JohnFrei/Box-Joint-Jig/README.md

# Box-Joint-Jig
Plans for a Box Joint Jig
