JohnFrei/Box-Joint-Jig/templates/Scaling Readme.docx

The scaling for the gears should be 1.02 using PDF “all_sizes” document.
