JohnFrei/Box-Joint-Jig/plans.pdf

# How to view the screw advance box joint jig plans

To view the plans, you need to fully extract the entire zip file.

Extracting the zip file will create a folder with the plans in them.

Then navigate into the folder that the zip file was extracted into and double click on "index.html". If you click on the "index.html in the zip file directly, you will not be able to see the images or navigate between pages.

This file "plans.pdf" does not contain the plans (see below)

If you encounter any problems or have questions, please feel free to email me at: matthias@woodgears.ca

You may wonder, why does the file called "plans.pdf" not contain the actual plans? I have difficulty getting people to read the instructions about unpacking the
zip file, despite indicating how every step along the way. So the hope is that
if you don't read the instructions, you may open "plans.pdf" and then, finally,
read about unpacking the zip file. Enjoy the plans :)
