JohnFrei/Box-Joint-Jig/templates/1-1_small.pdf

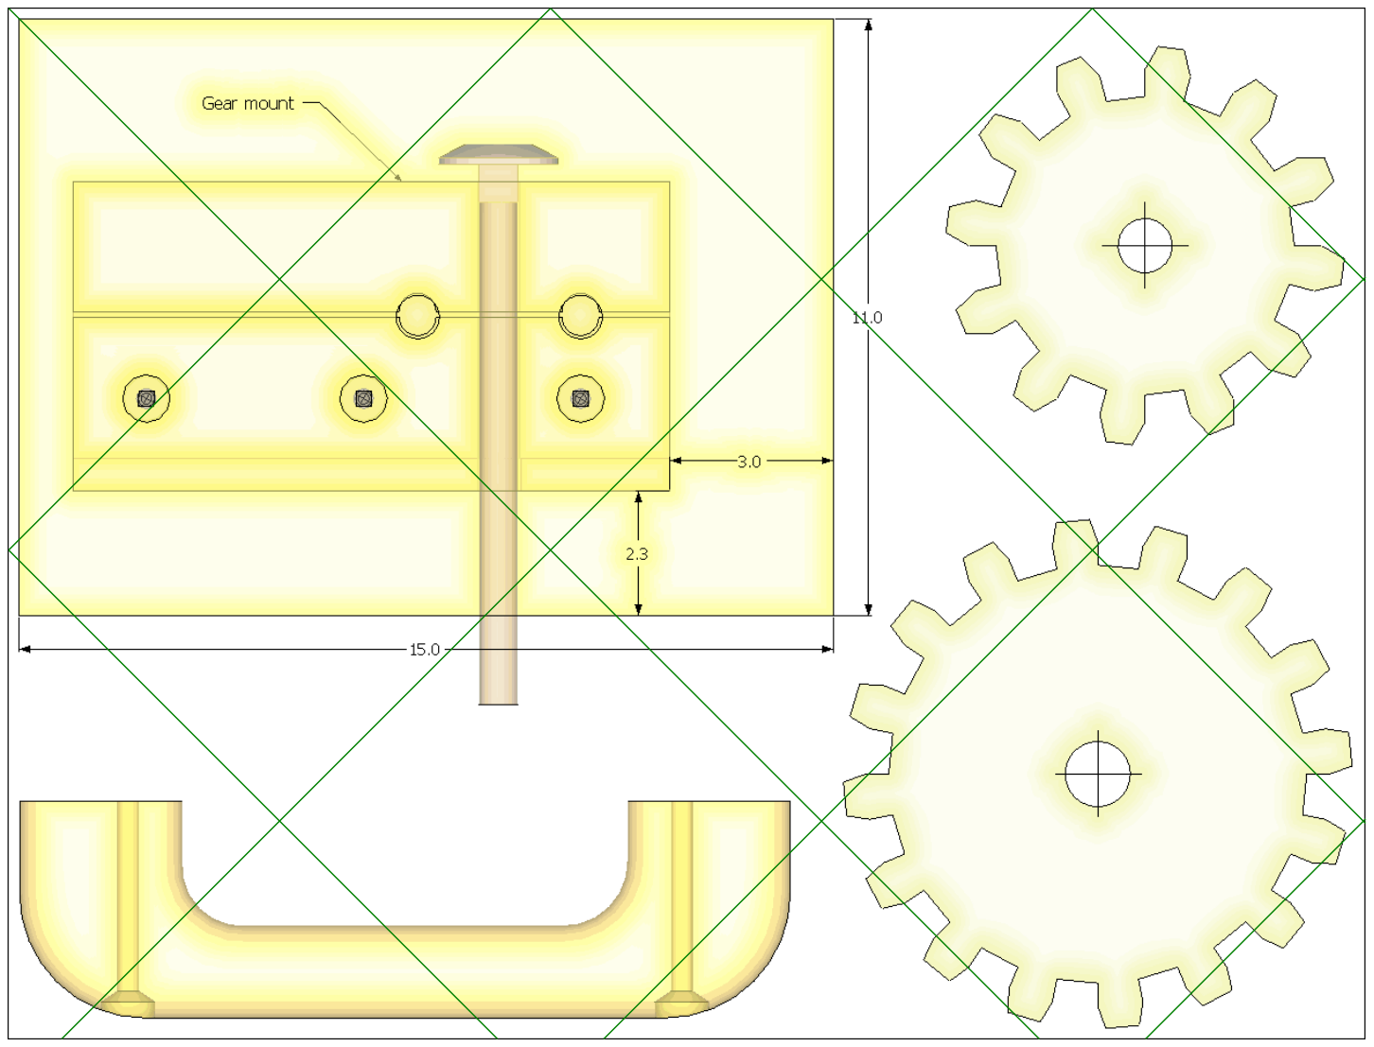
[picture p1: page 1]
