JohnFrei/Box-Joint-Jig/plans/base.png

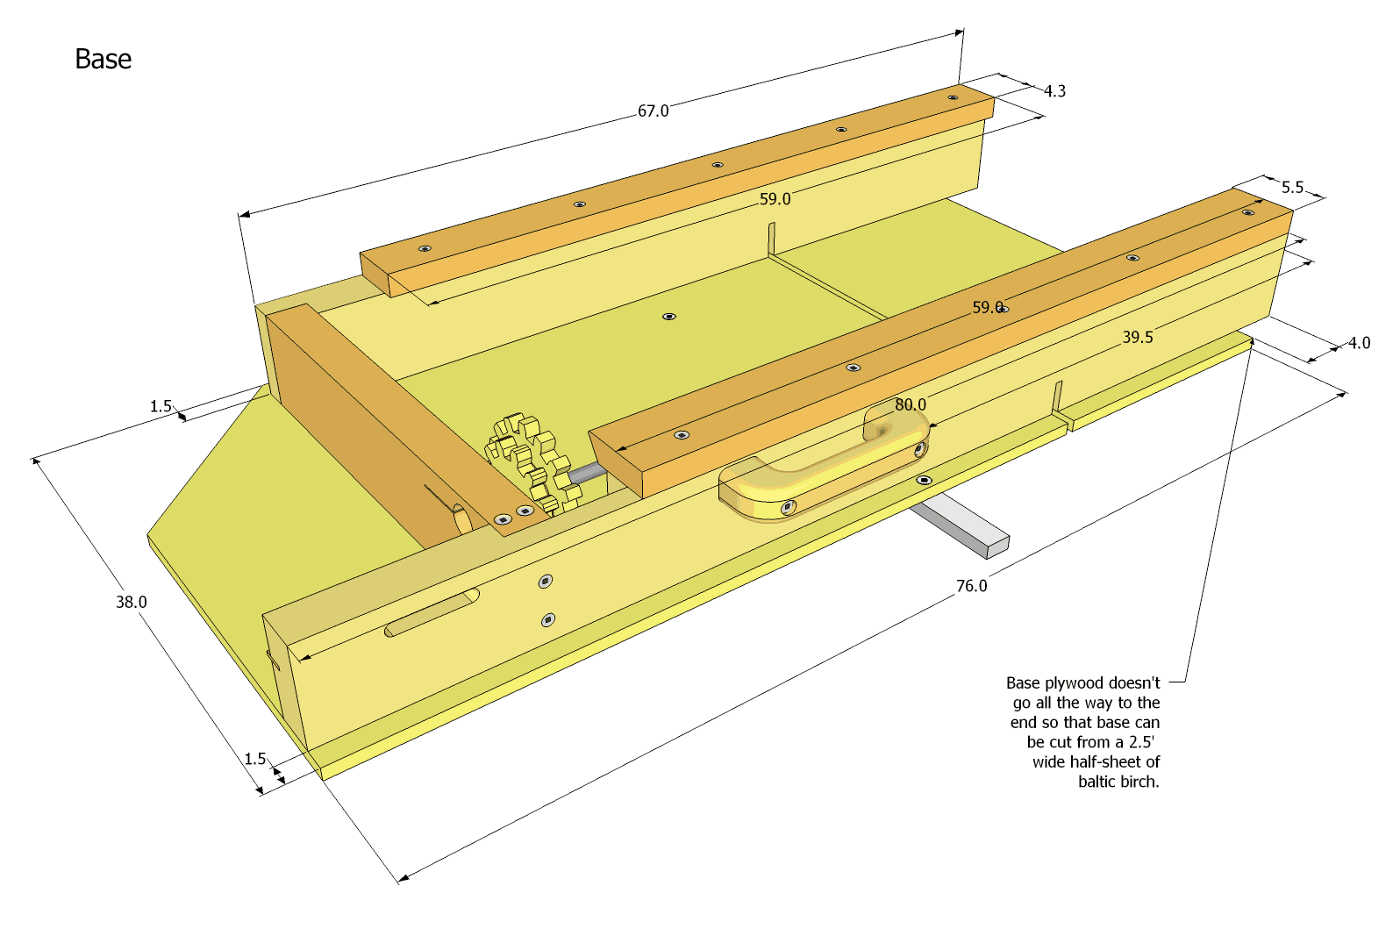
plans/base.png
