JohnFrei/Box-Joint-Jig/plans/base_plywood.png

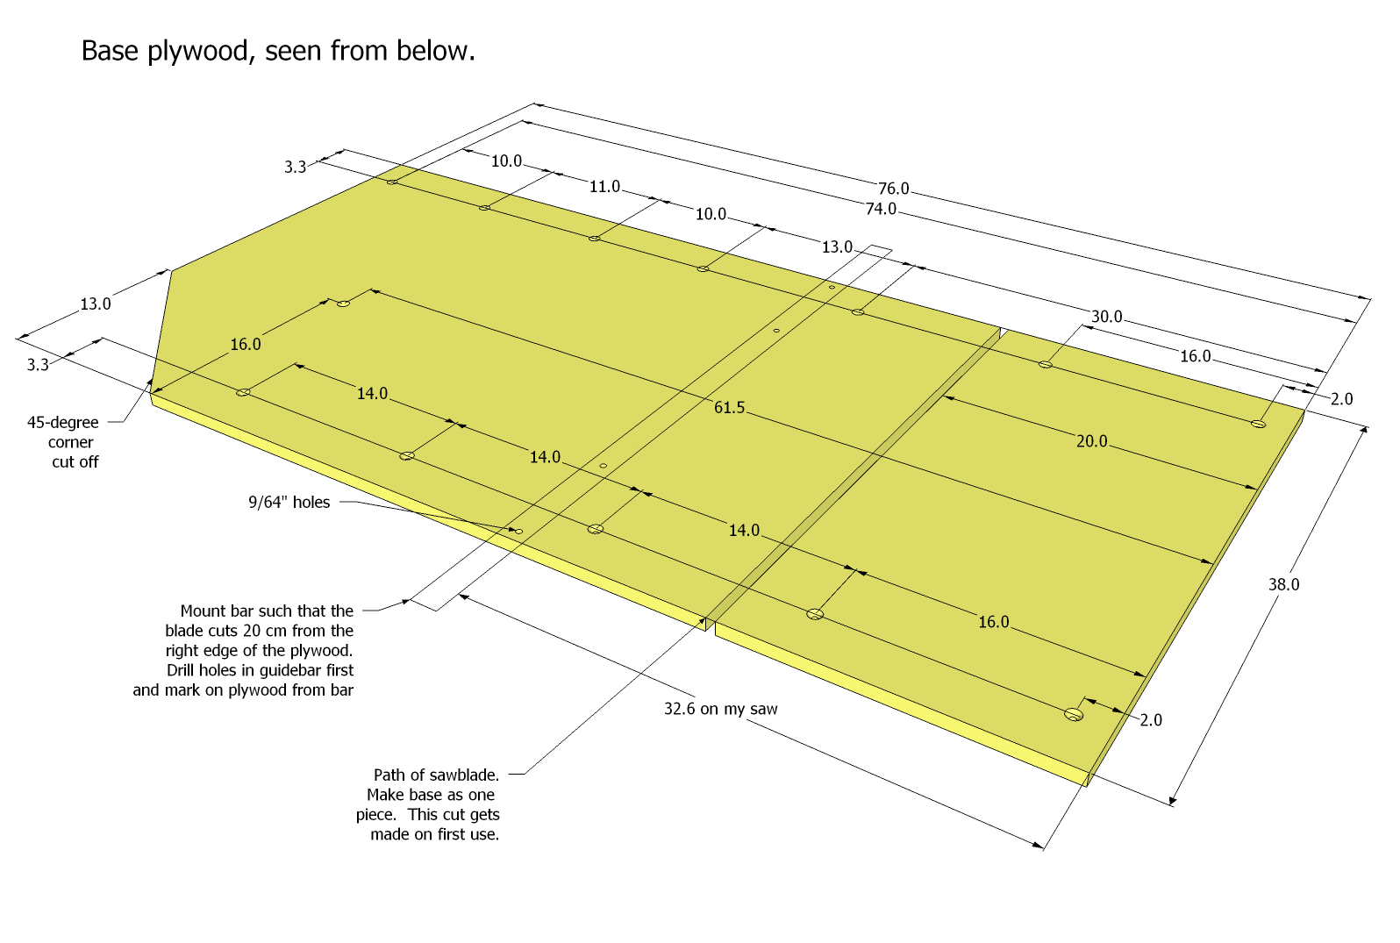
plans/base_plywood.png
