JohnFrei/Box-Joint-Jig/plans/box_basic.png

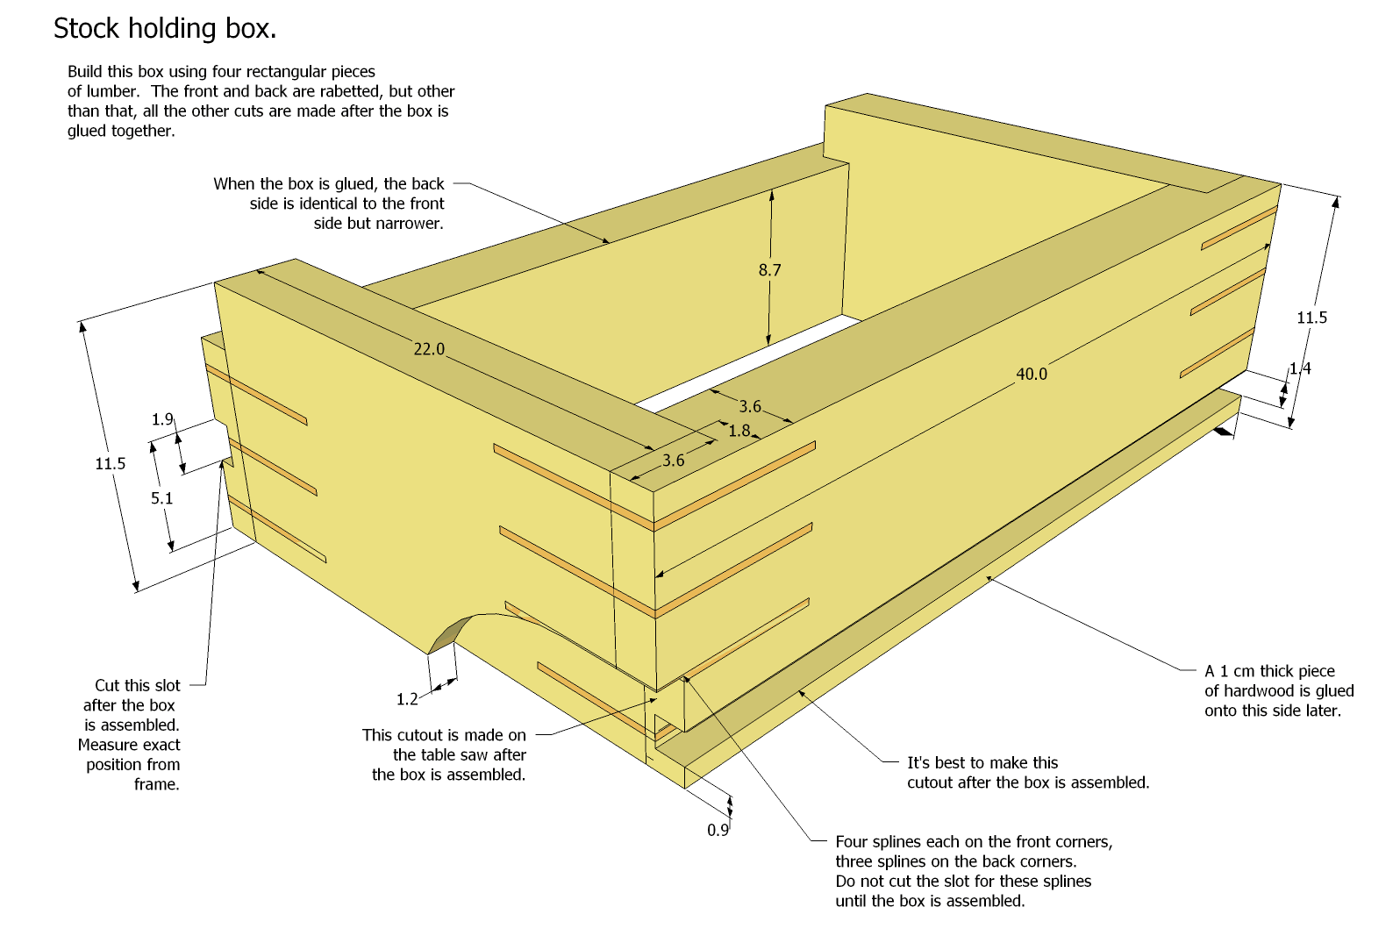
plans/box_basic.png
