JohnFrei/Box-Joint-Jig/plans/box_profile.png

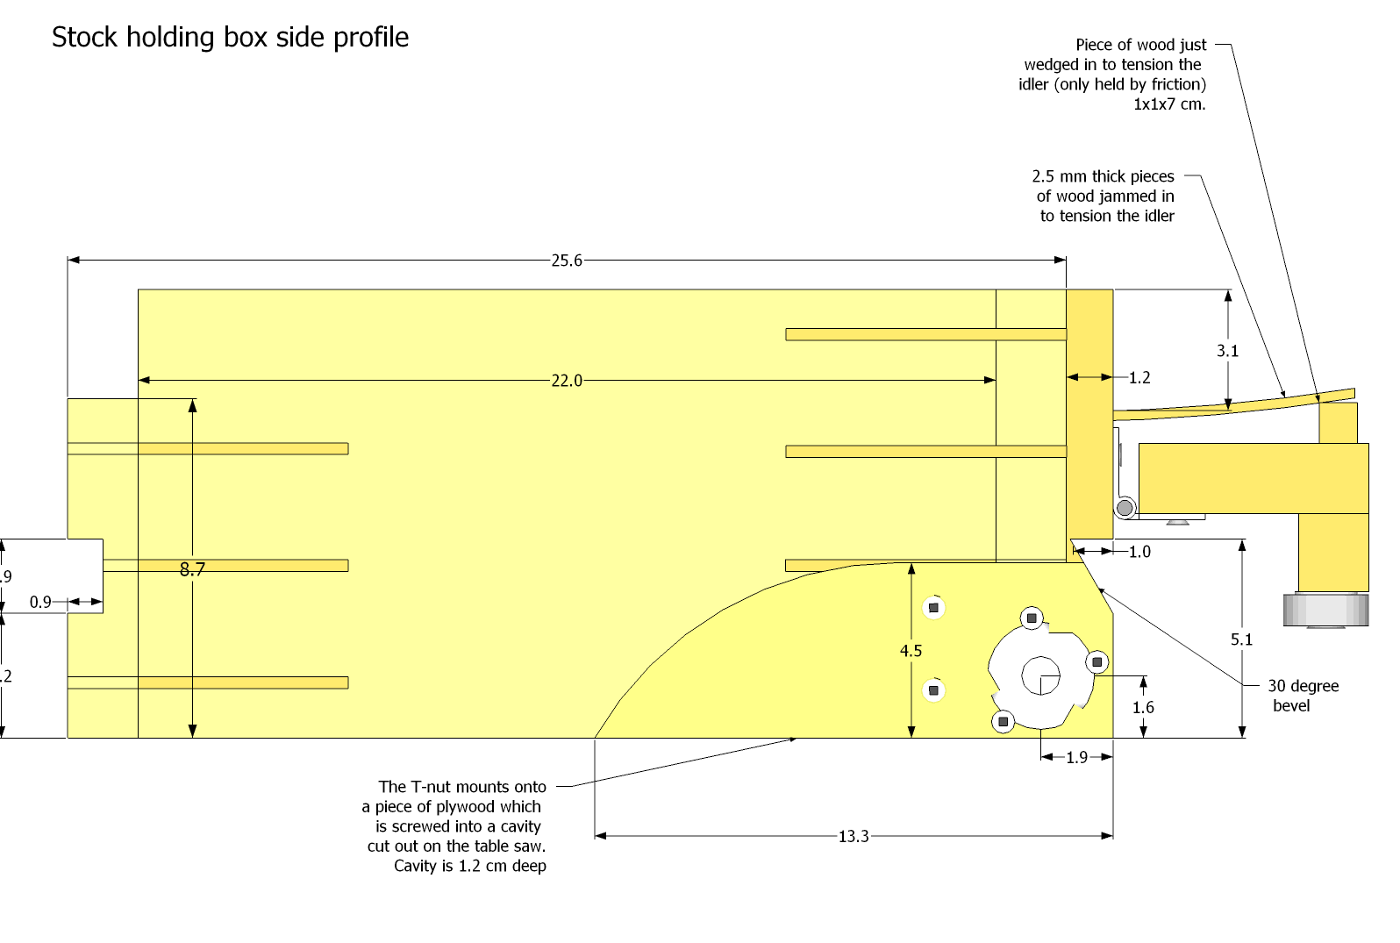
plans/box_profile.png
