JohnFrei/Box-Joint-Jig/plans/box_rails.png

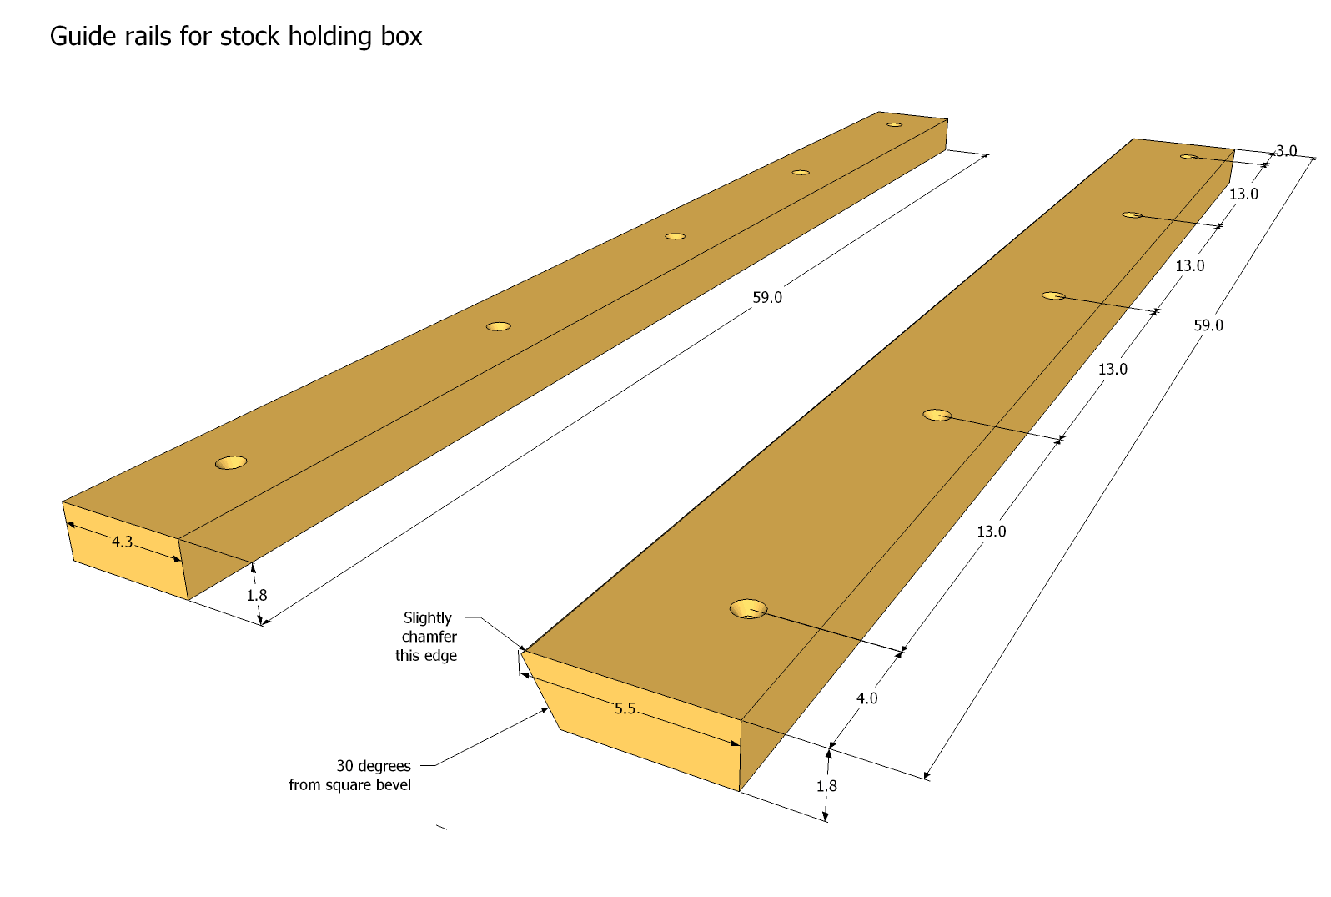
plans/box_rails.png
