JohnFrei/Box-Joint-Jig/plans/frame_f_r.png

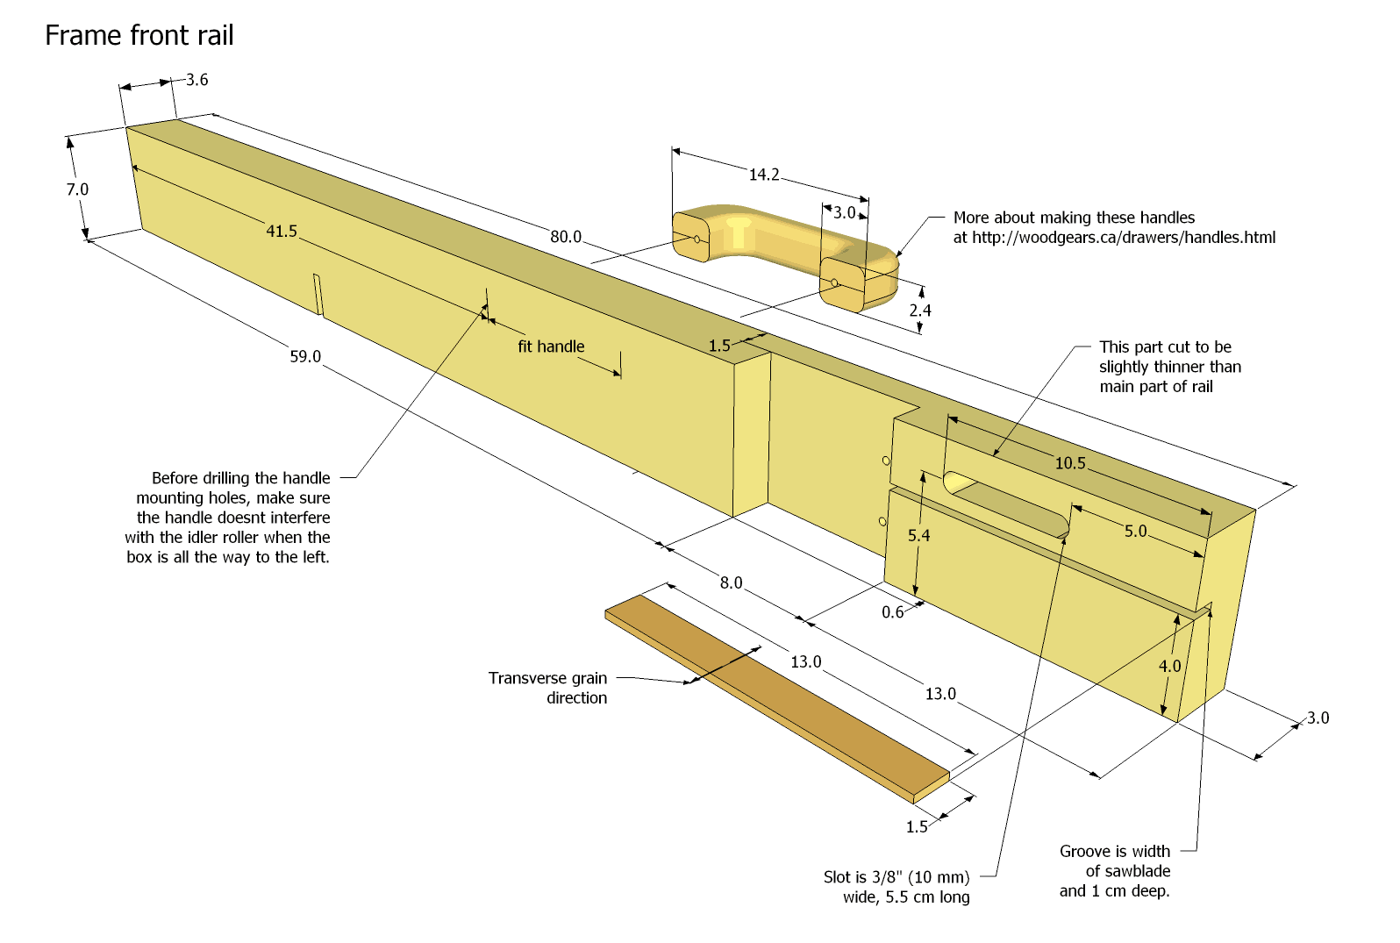
plans/frame_f_r.png
