JohnFrei/Box-Joint-Jig/plans/frame_other.png

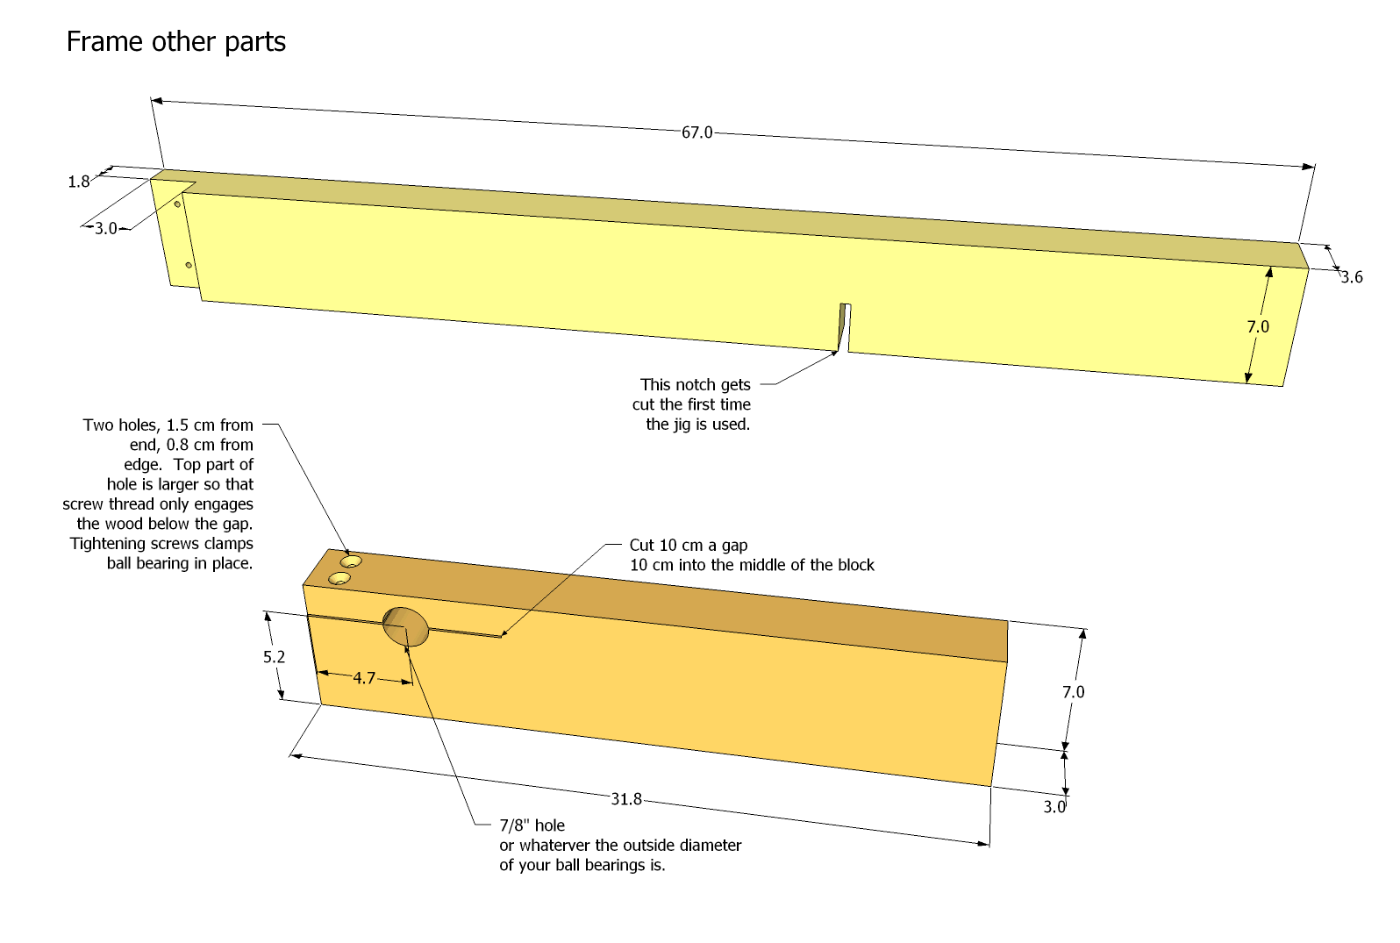
plans/frame_other.png
