JohnFrei/Box-Joint-Jig/plans/gear_mount.png

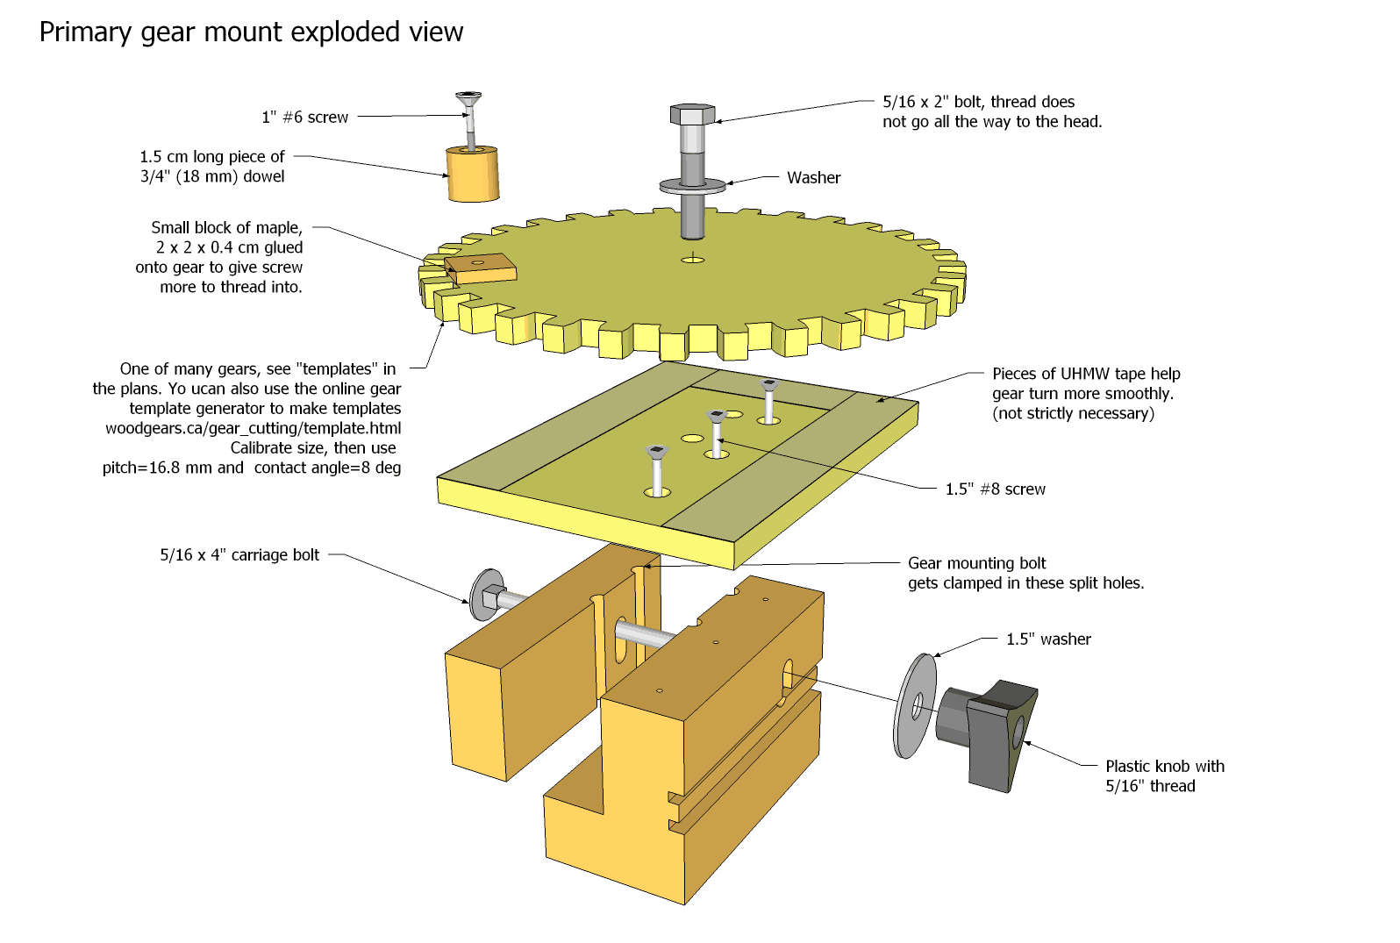
plans/gear_mount.png
