JohnFrei/Box-Joint-Jig/plans/gear_mount_dim.png

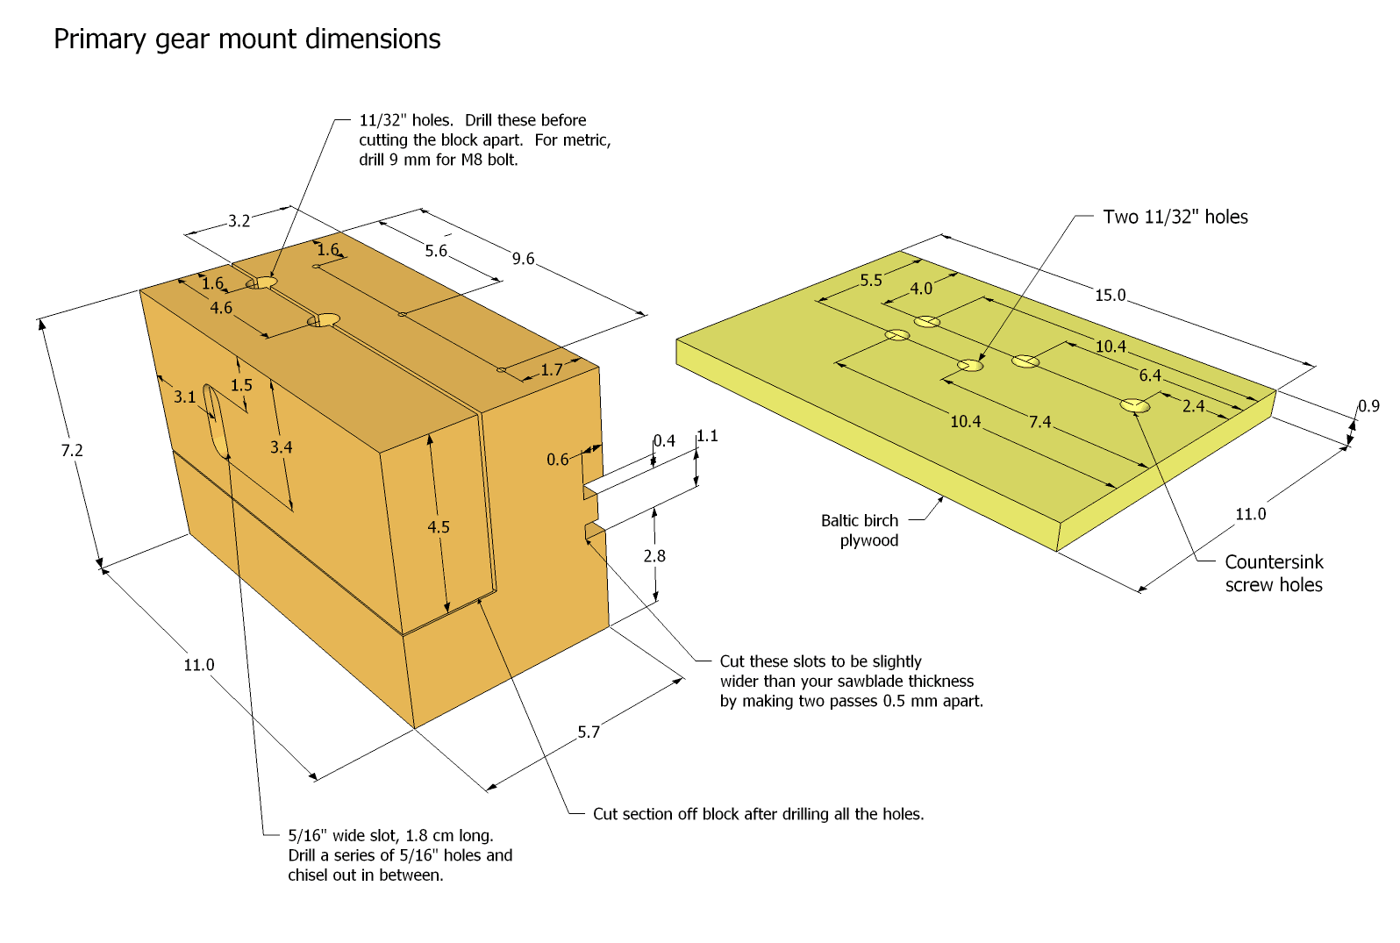
plans/gear_mount_dim.png
