JohnFrei/Box-Joint-Jig/plans/gear_shaft.png

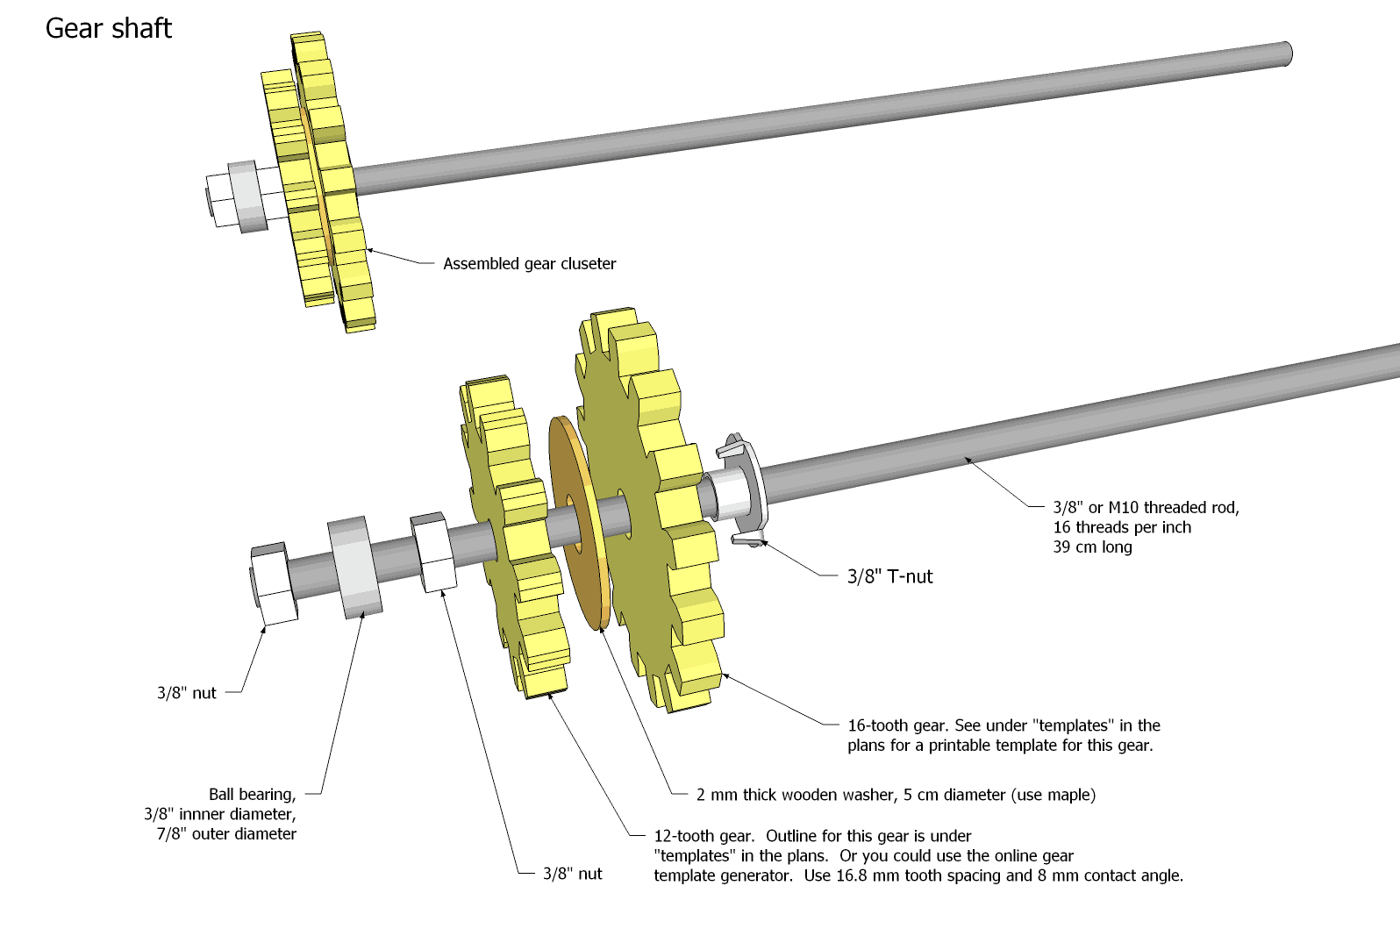
plans/gear_shaft.png
