JohnFrei/Box-Joint-Jig/plans/hardware_list.png

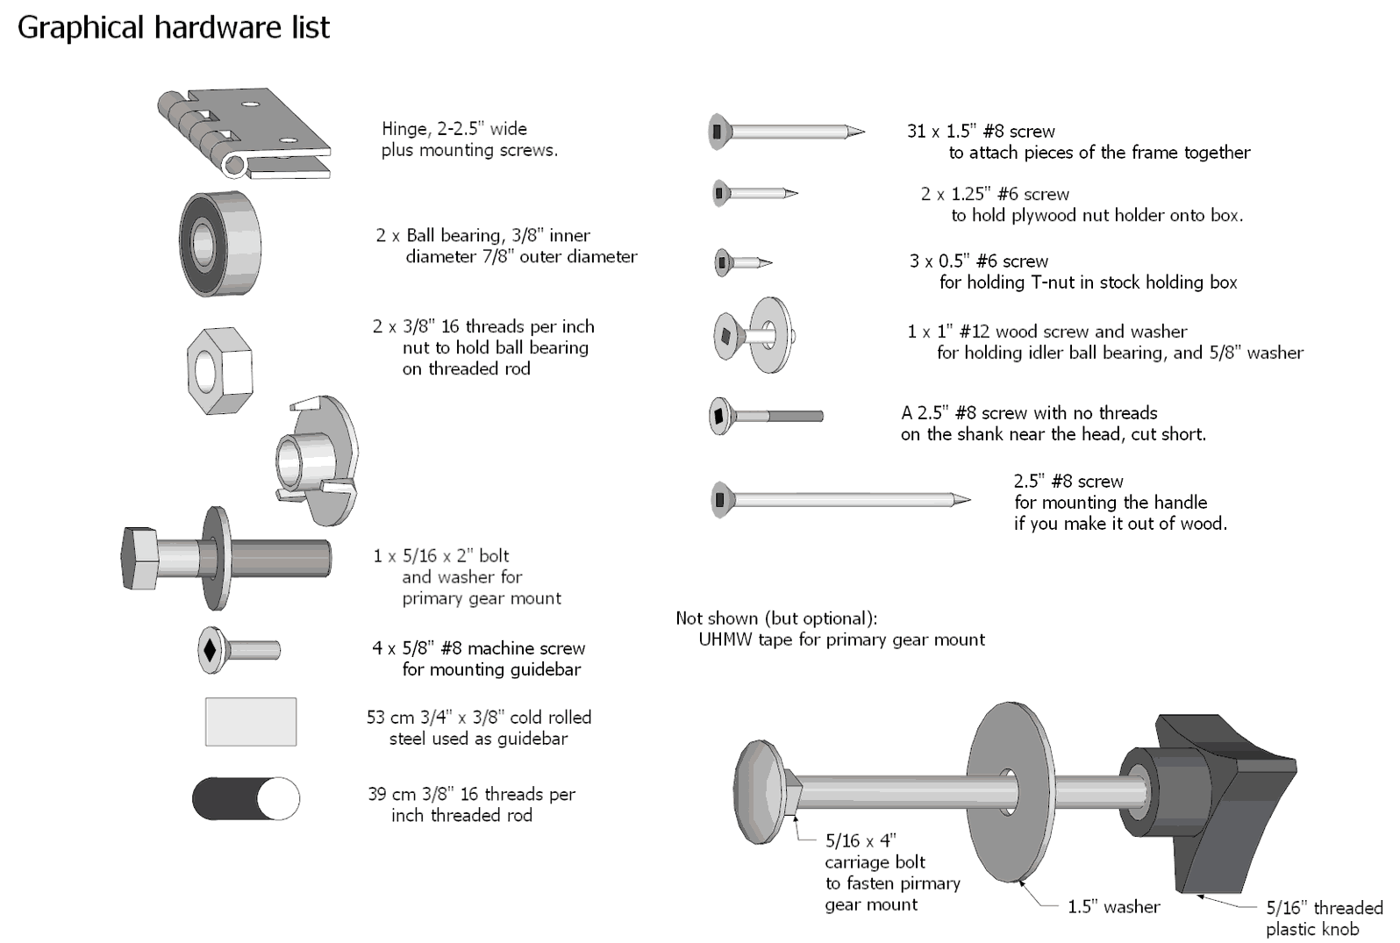
plans/hardware_list.png
