JohnFrei/Box-Joint-Jig/plans/idler.png

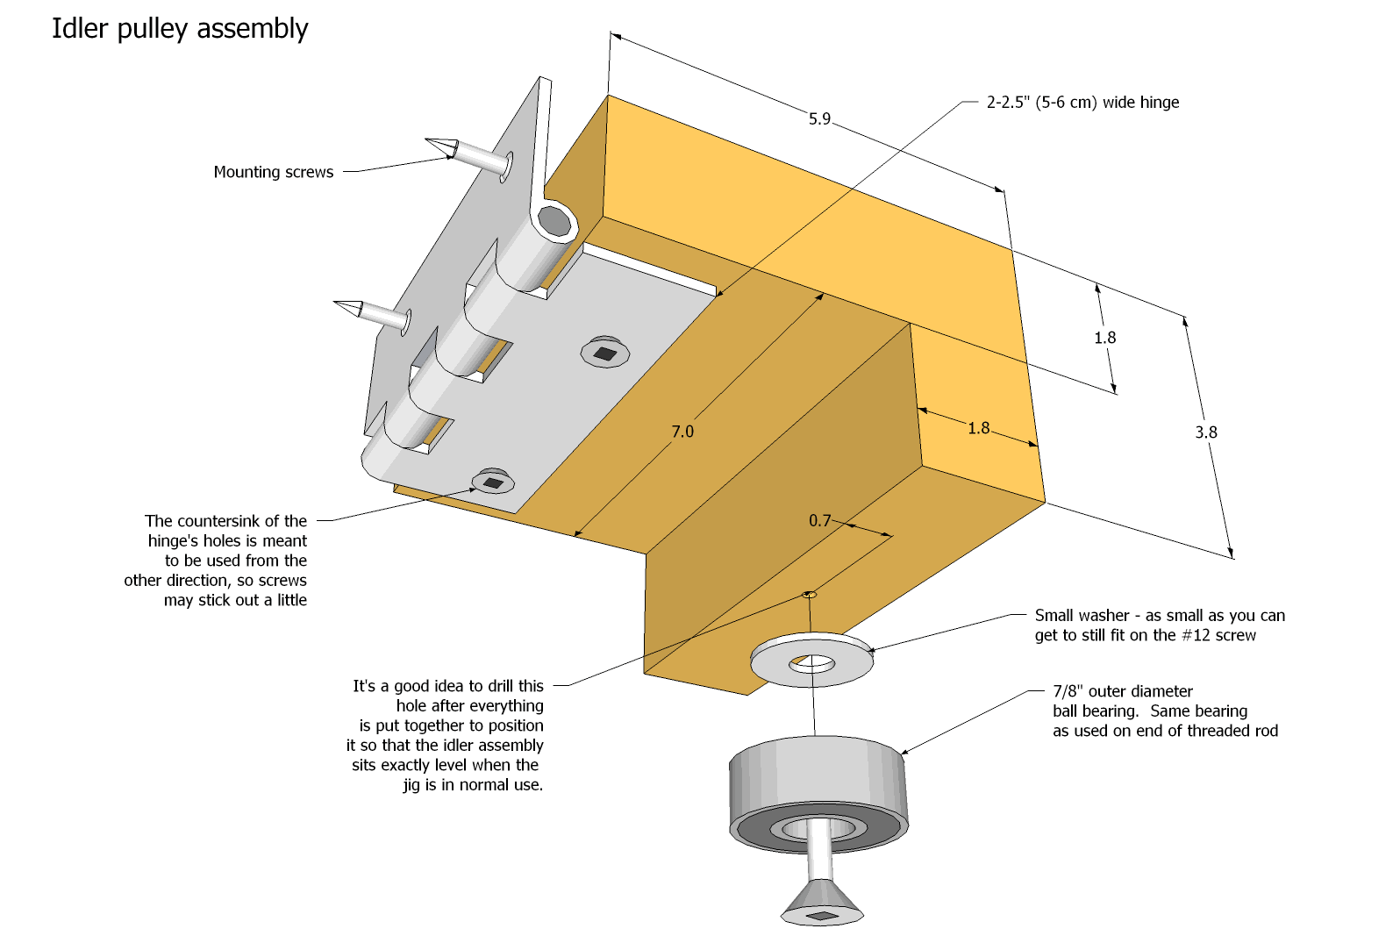
plans/idler.png
