JohnFrei/Box-Joint-Jig/plans/main2.png

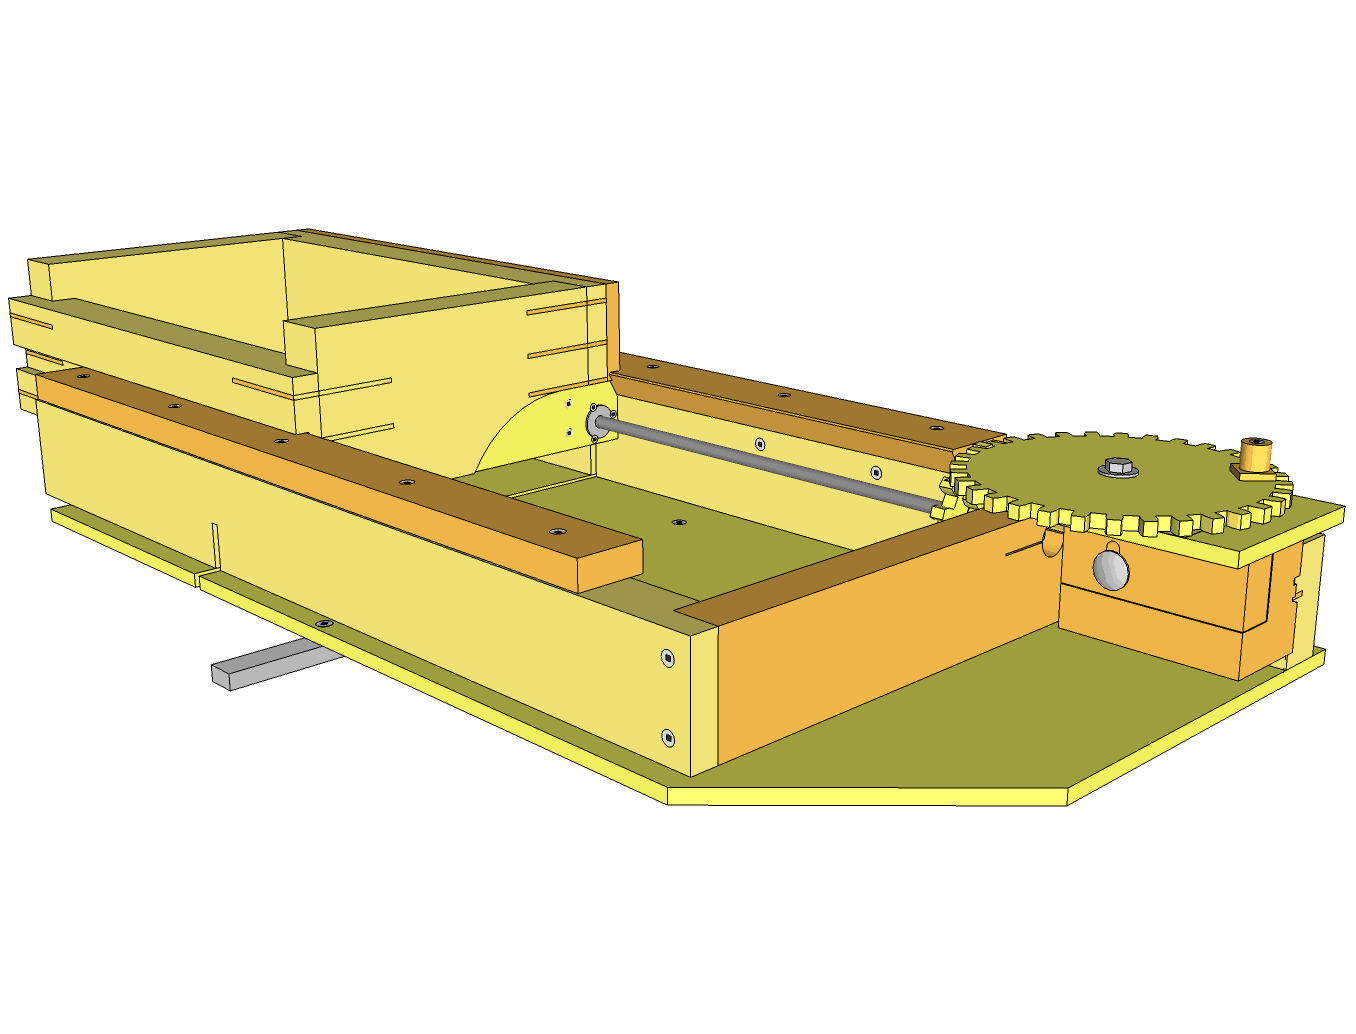
plans/main2.png
