JohnFrei/Box-Joint-Jig/plans/main.png

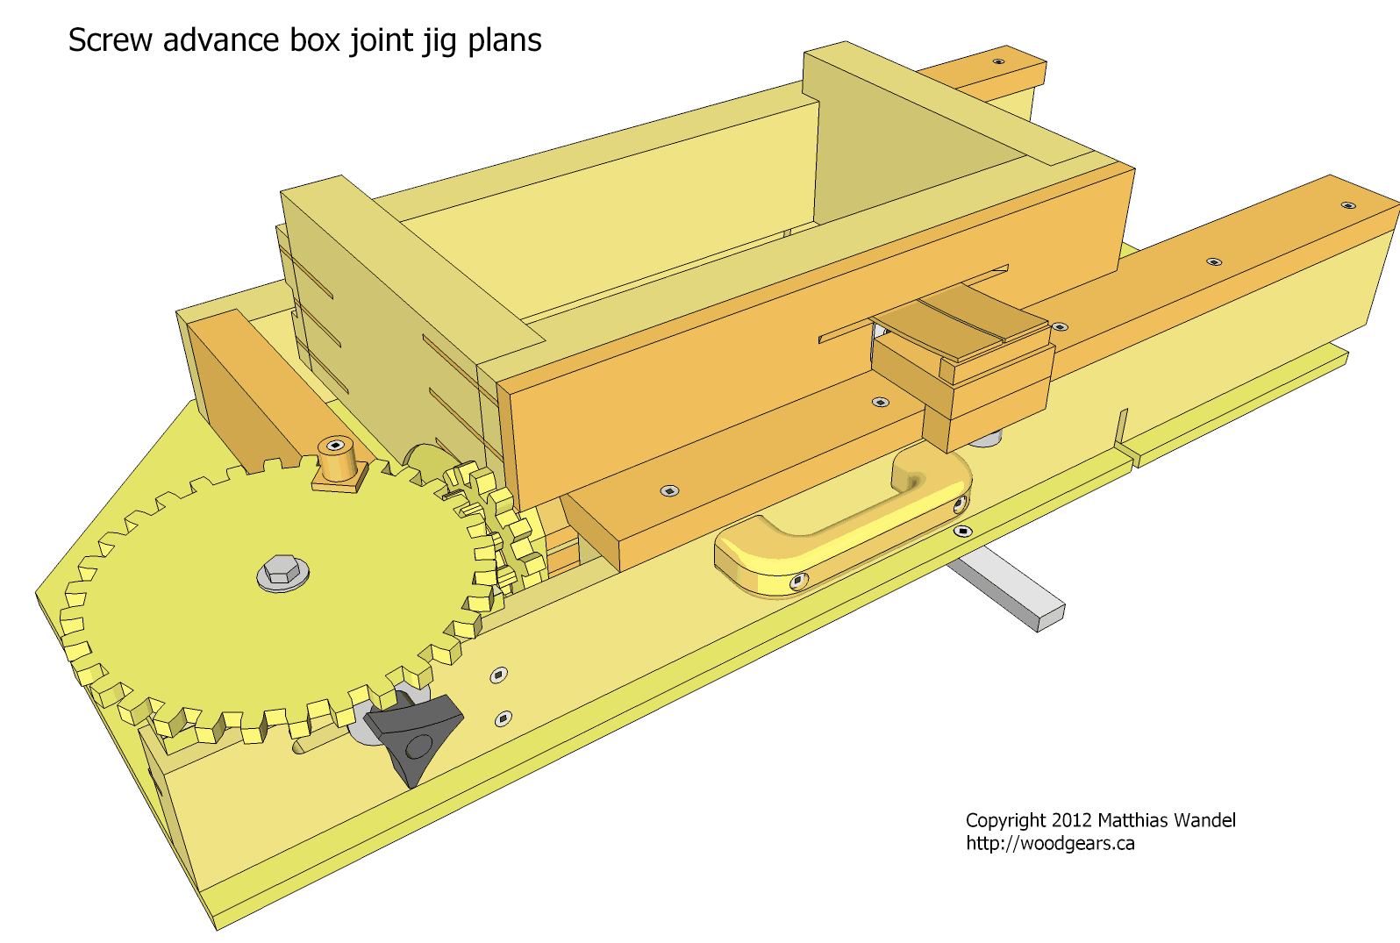
plans/main.png
