JohnFrei/Box-Joint-Jig/plans/thumbnail/box_profile.png

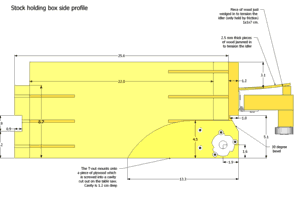
plans/thumbnail/box_profile.png
