JohnFrei/Box-Joint-Jig/plans/thumbnail/main.png

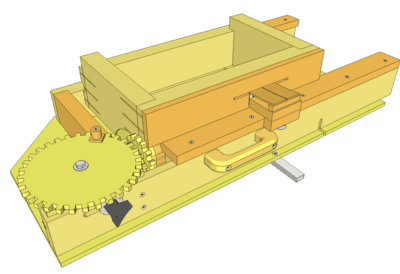
plans/thumbnail/main.png
