JohnFrei/Box-Joint-Jig/templates/1-1_small.png

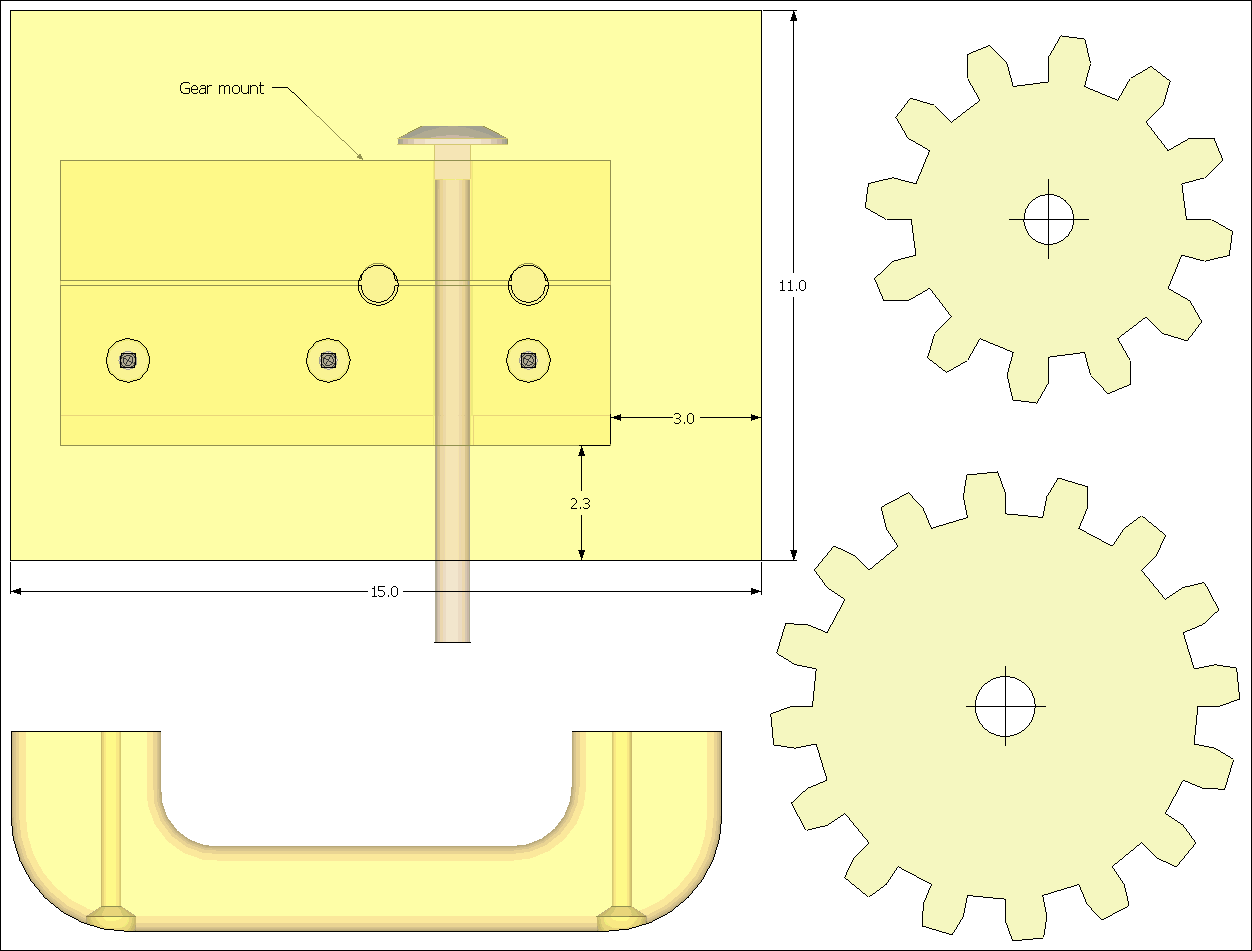
templates/1-1_small.png
