JohnFrei/Box-Joint-Jig/templates/1-1_top_view.png

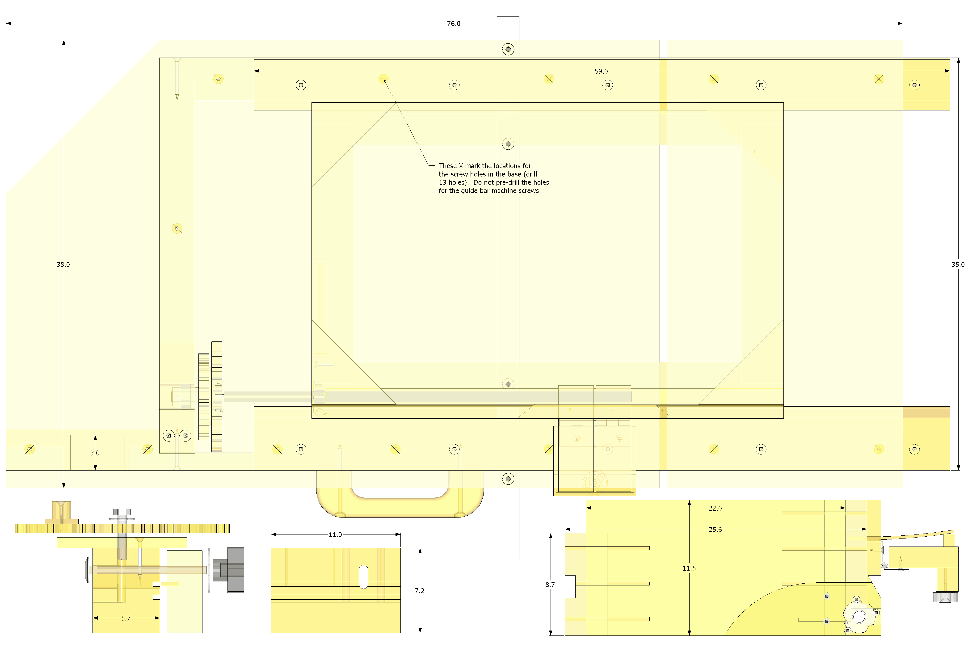
templates/1-1_top_view.png
