JohnFrei/Box-Joint-Jig/templates/12.png

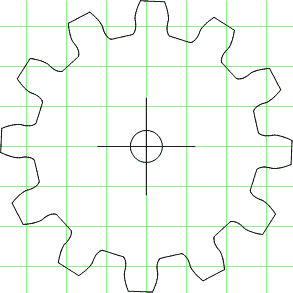
templates/12.png
