JohnFrei/Box-Joint-Jig/templates/16.png

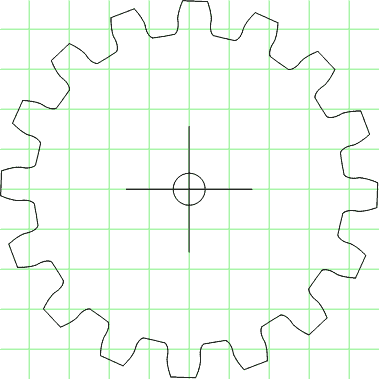
templates/16.png
