JohnFrei/Box-Joint-Jig/templates/19.png

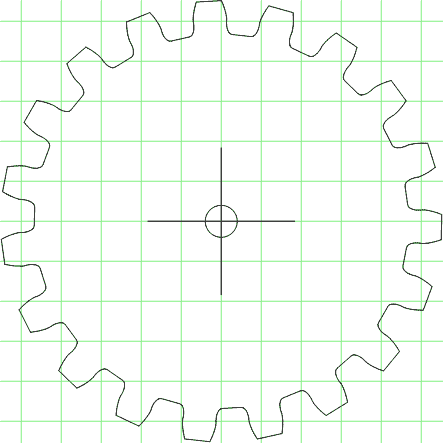
templates/19.png
