JohnFrei/Box-Joint-Jig/templates/20.png

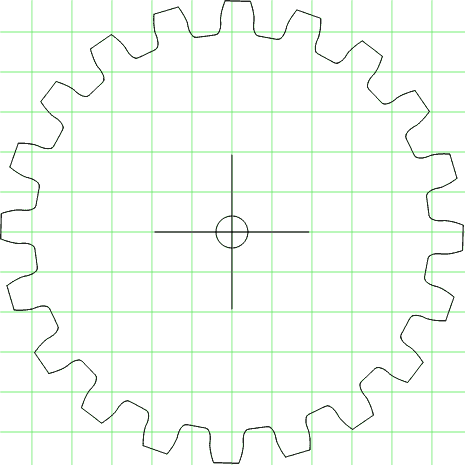
templates/20.png
