JohnFrei/Box-Joint-Jig/templates/21.png

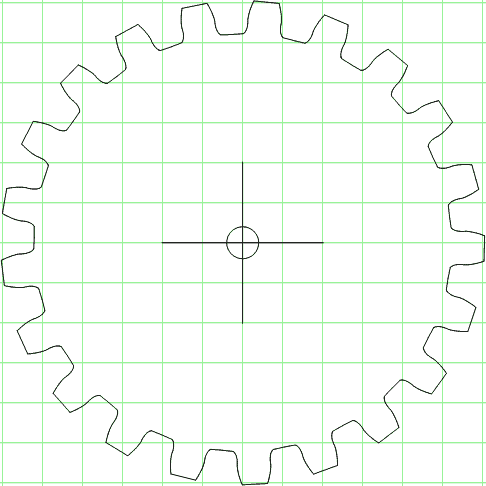
templates/21.png
