JohnFrei/Box-Joint-Jig/templates/23.png

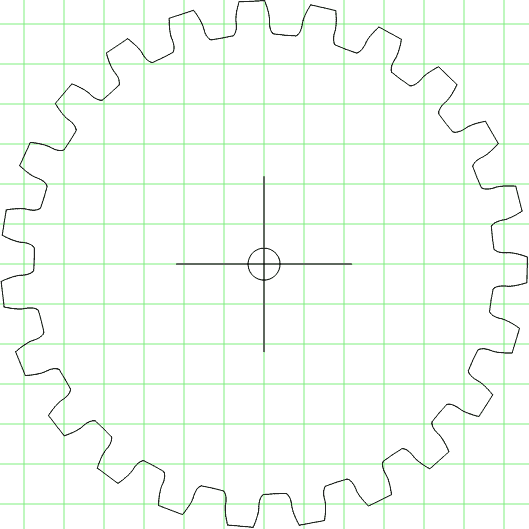
templates/23.png
