JohnFrei/Box-Joint-Jig/templates/25.png

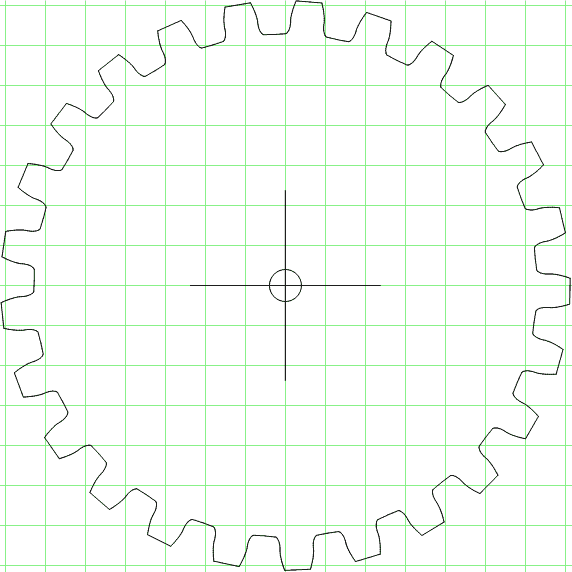
templates/25.png
