JohnFrei/Box-Joint-Jig/templates/26.png

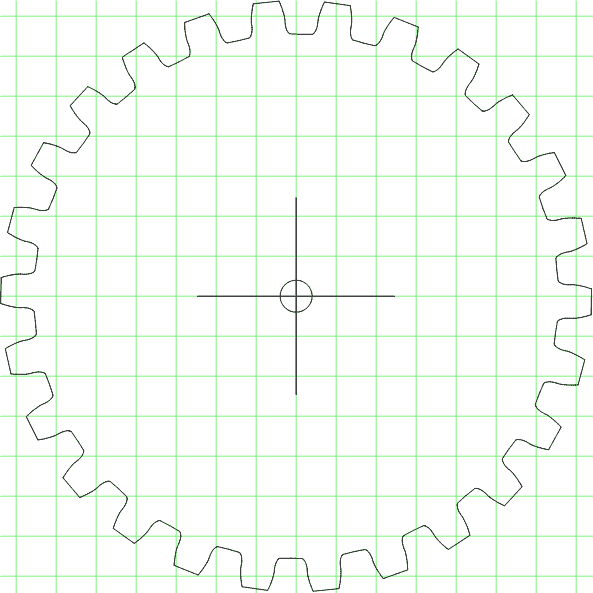
templates/26.png
