JohnFrei/Box-Joint-Jig/templates/27.png

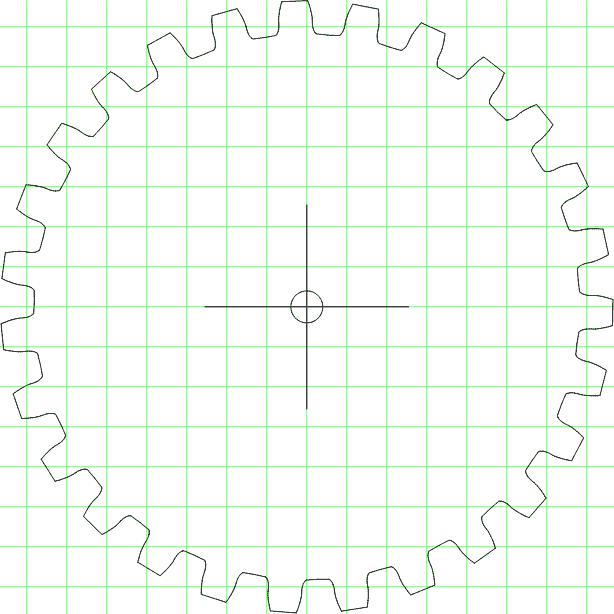
templates/27.png
