JohnFrei/Box-Joint-Jig/templates/28.png

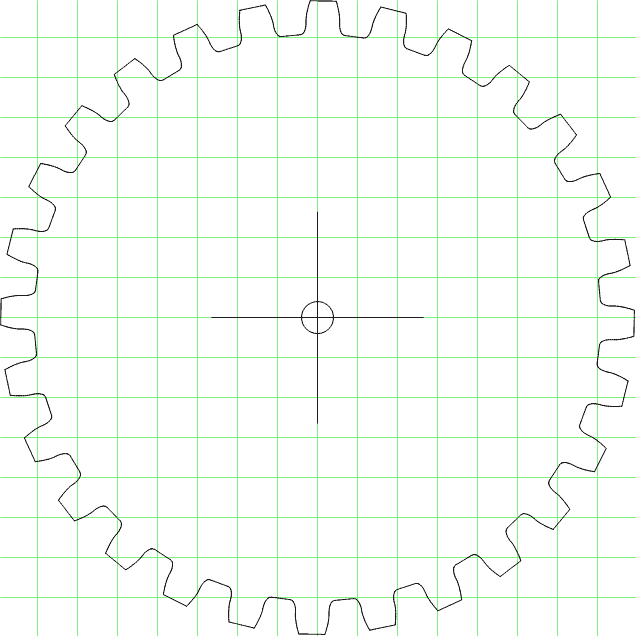
templates/28.png
