JohnFrei/Box-Joint-Jig/templates/29.png

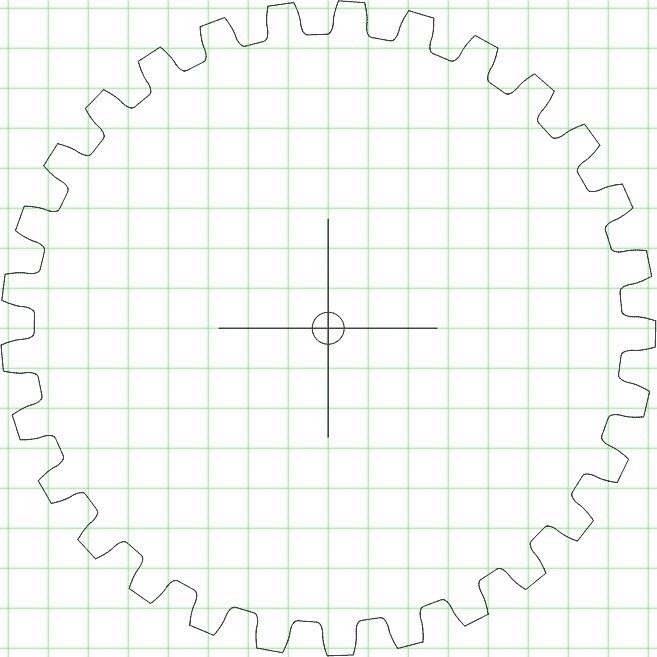
templates/29.png
