JohnFrei/Box-Joint-Jig/templates/30.png

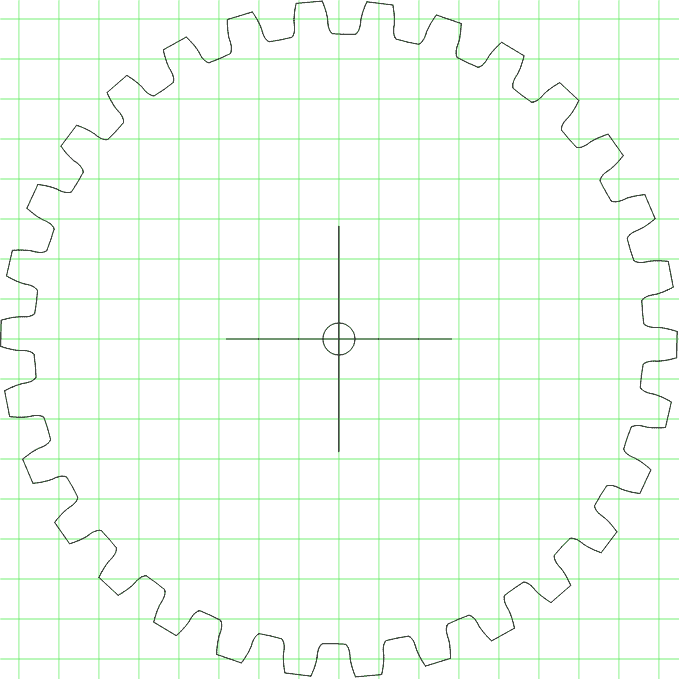
templates/30.png
