JohnFrei/Box-Joint-Jig/templates/31.png

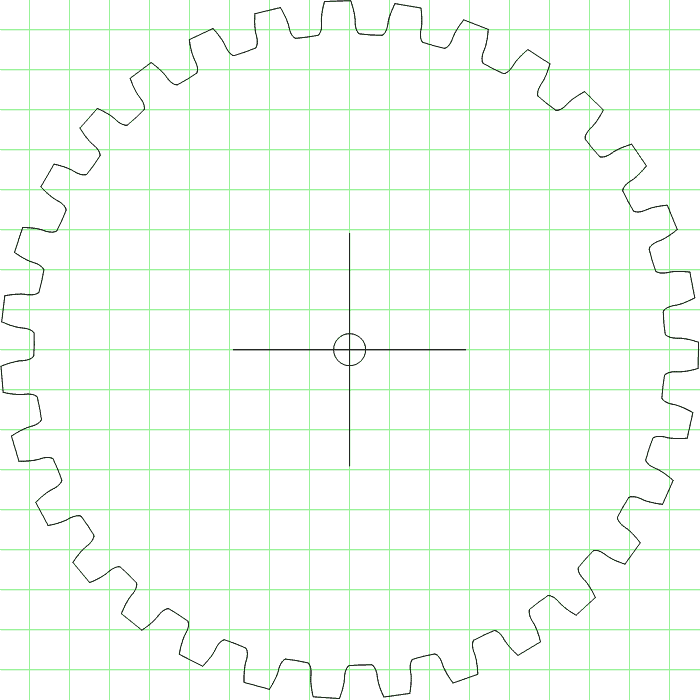
templates/31.png
