JohnFrei/Box-Joint-Jig/templates/32.png

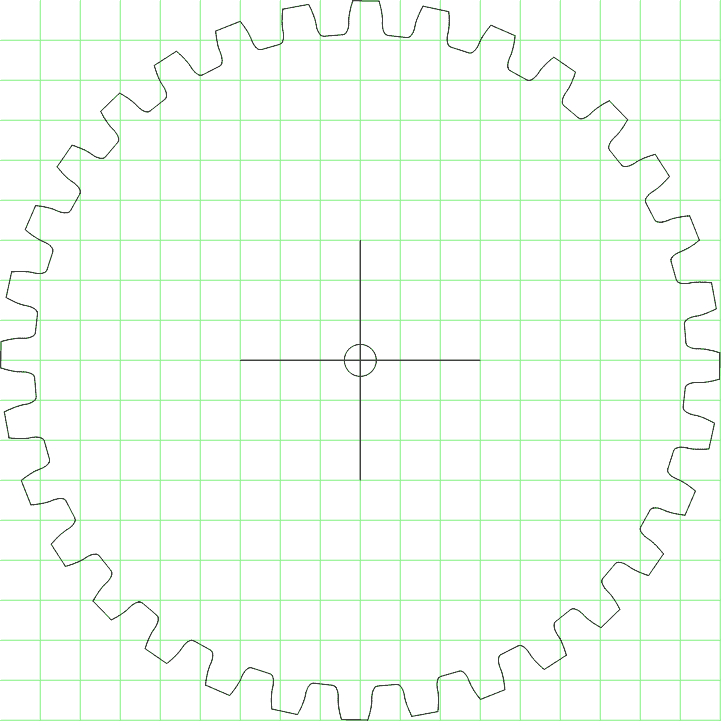
templates/32.png
