JohnFrei/Box-Joint-Jig/templates/33.png

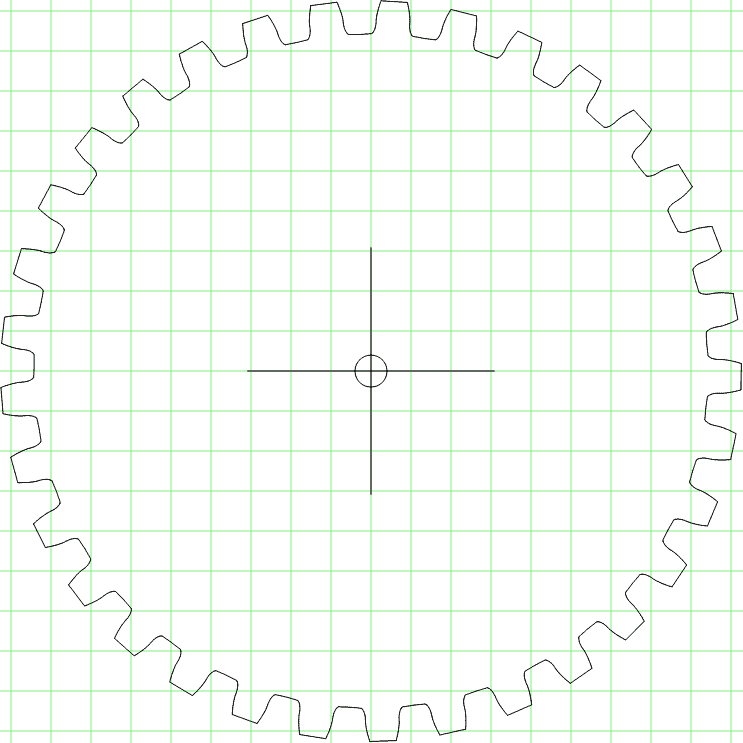
templates/33.png
