JohnFrei/Box-Joint-Jig/templates/35.png

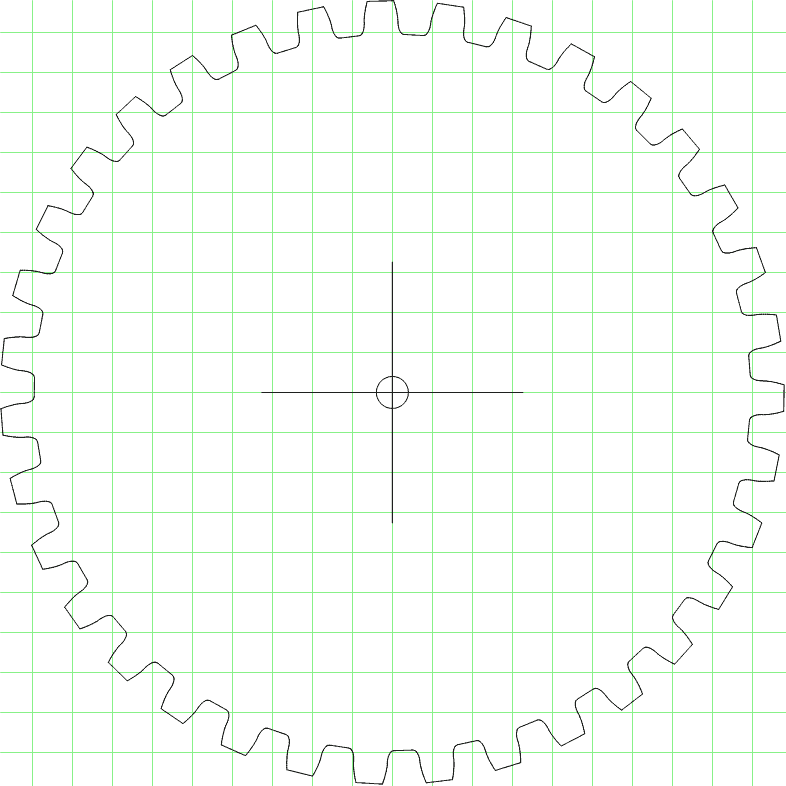
templates/35.png
