JohnFrei/Box-Joint-Jig/templates/36.png

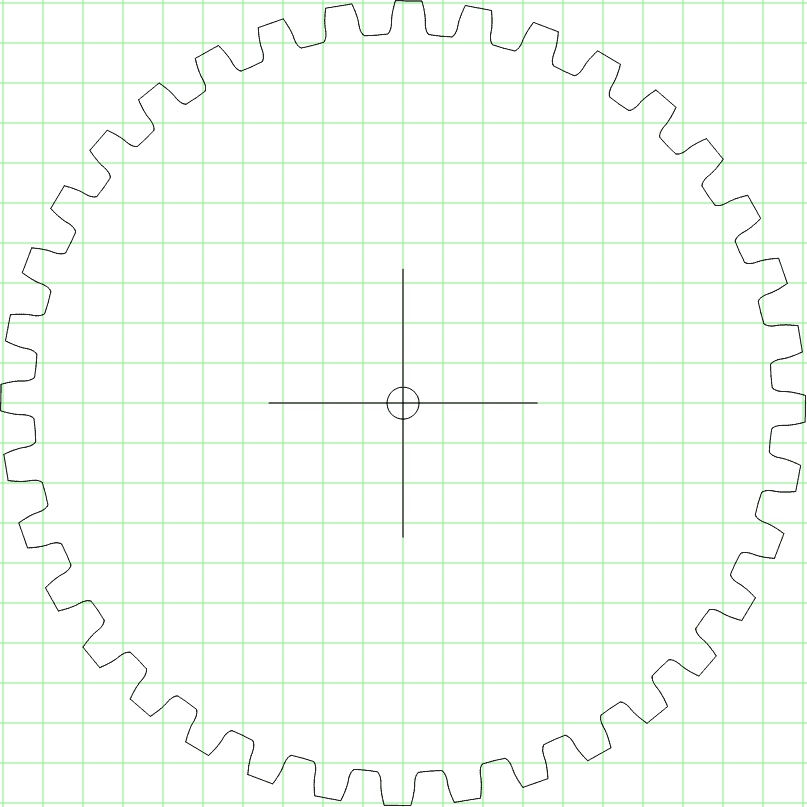
templates/36.png
