JohnFrei/Box-Joint-Jig/templates/37.png

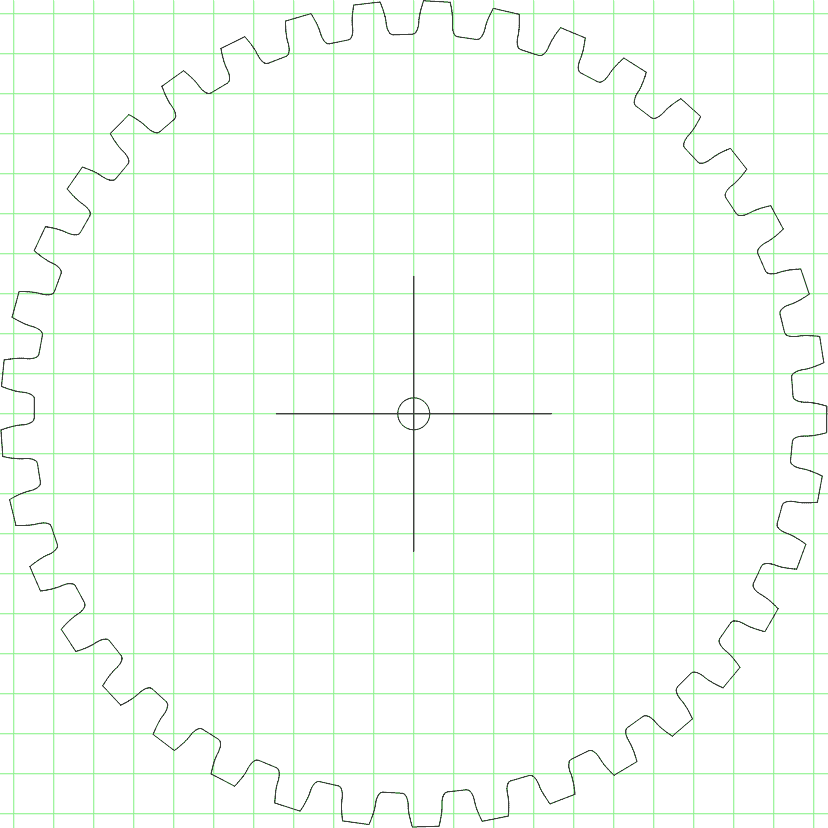
templates/37.png
