JohnFrei/Box-Joint-Jig/templates/39.png

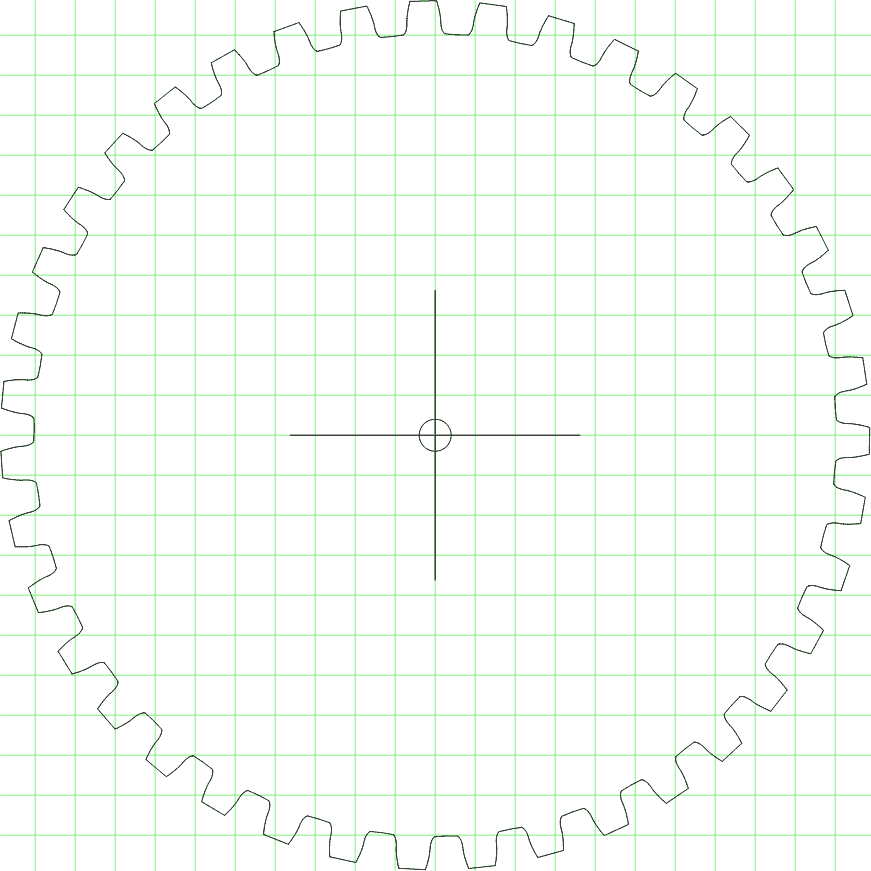
templates/39.png
