JohnFrei/Box-Joint-Jig/templates/40.png

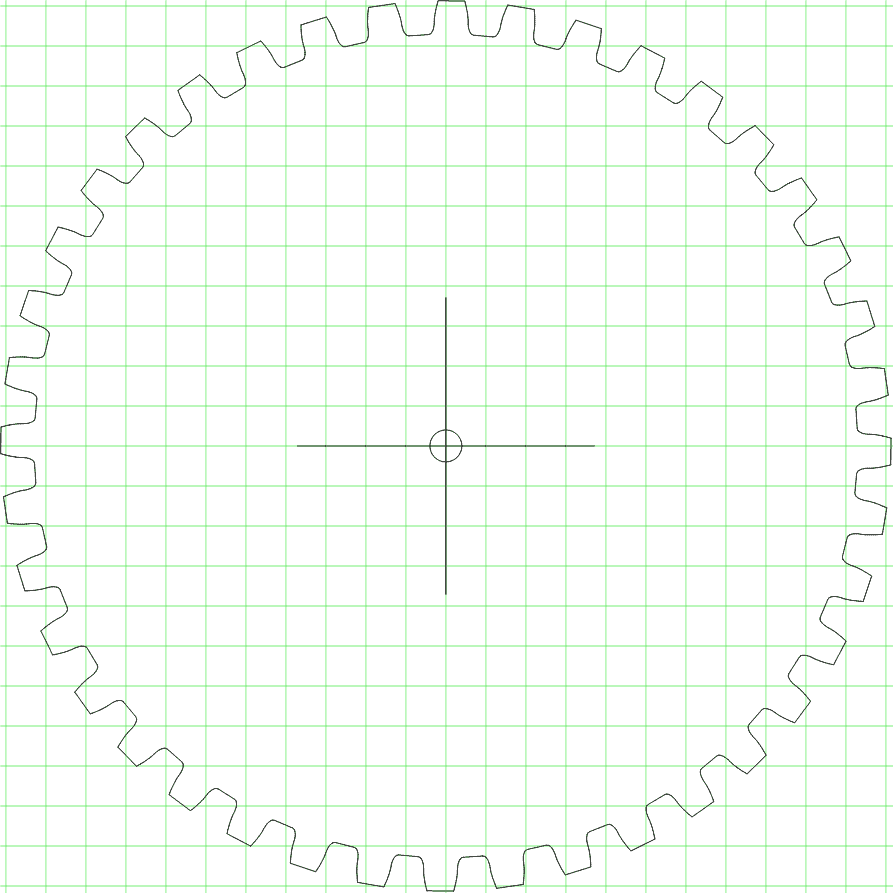
templates/40.png
