JohnFrei/Box-Joint-Jig/templates/41.png

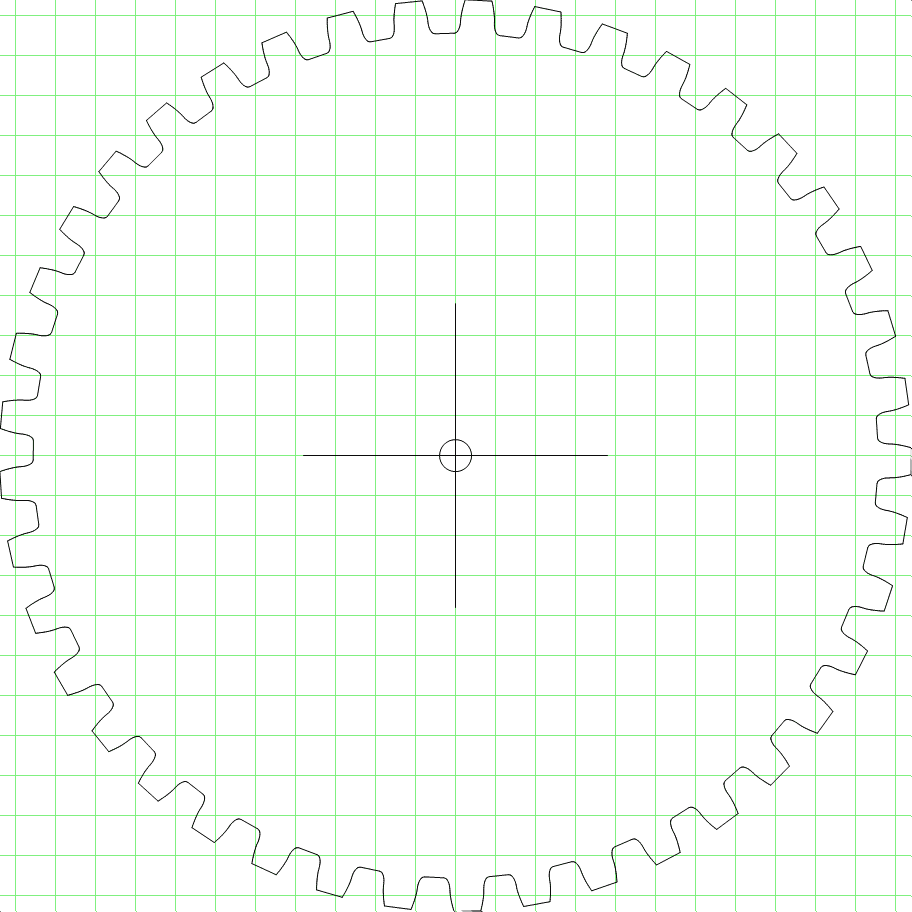
templates/41.png
