JohnFrei/Box-Joint-Jig/templates/42.png

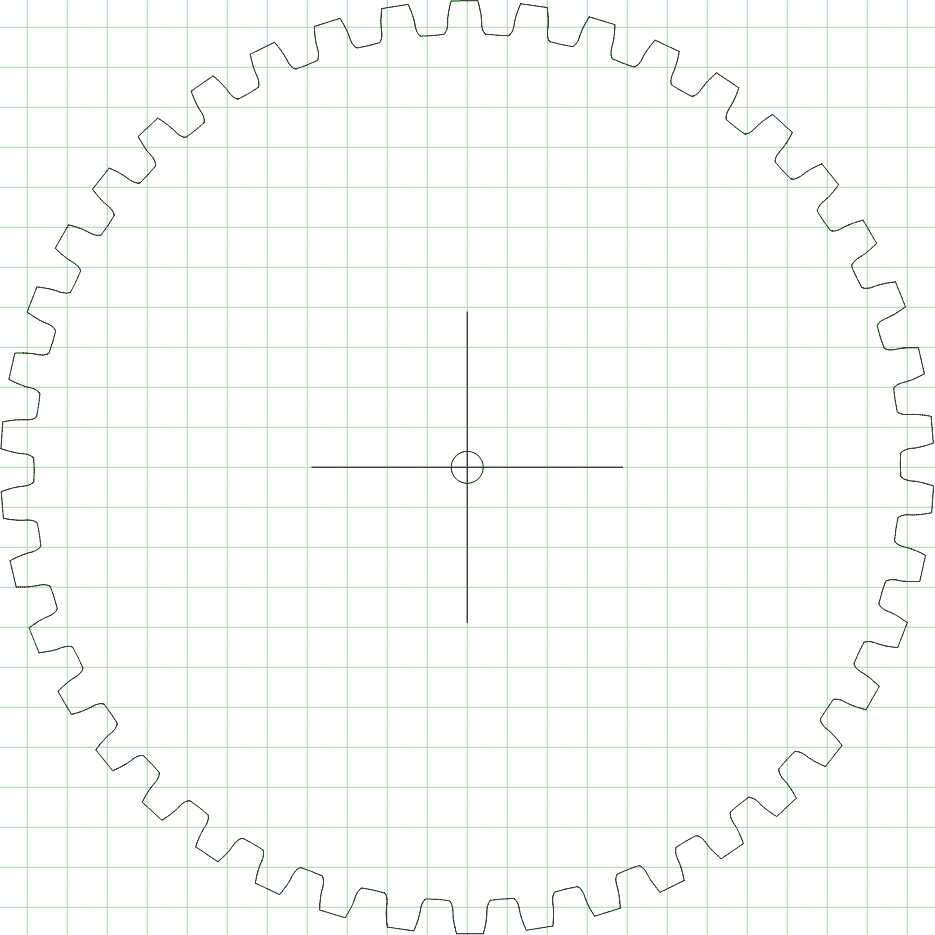
templates/42.png
