JohnFrei/Box-Joint-Jig/templates/44r.png

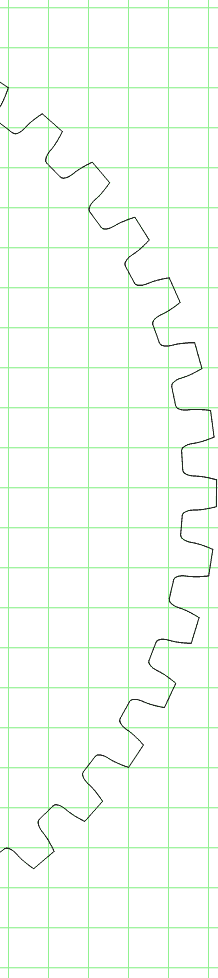
templates/44r.png
