JohnFrei/Box-Joint-Jig/templates/45.png

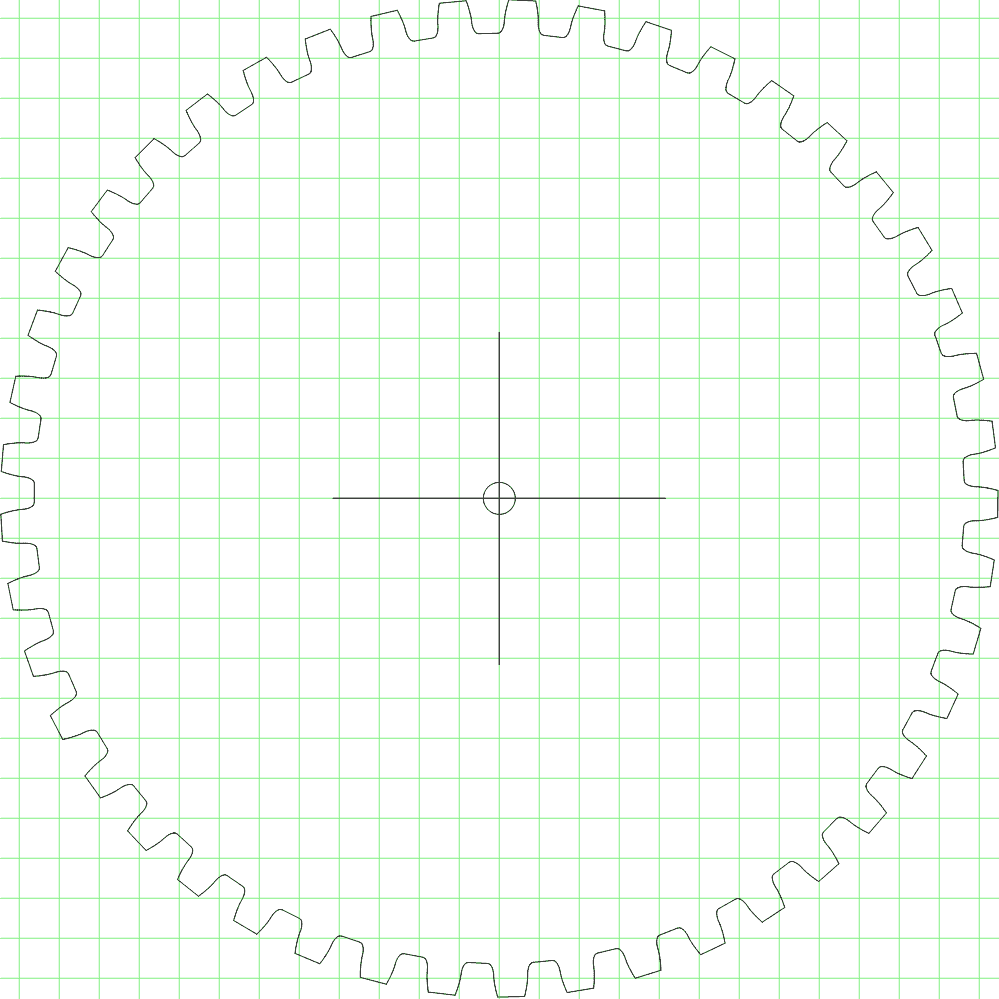
templates/45.png
