JohnFrei/Box-Joint-Jig/templates/45r.png

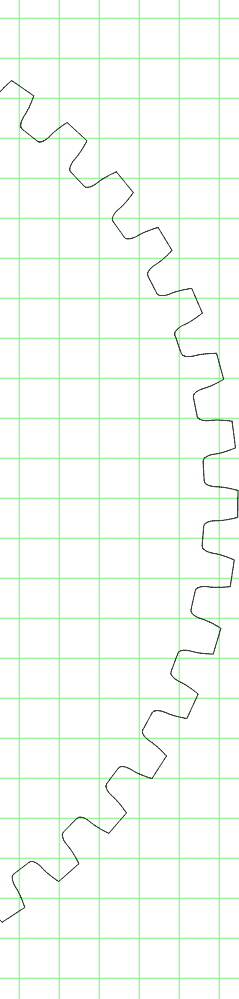
templates/45r.png
