JohnFrei/Box-Joint-Jig/templates/46.png

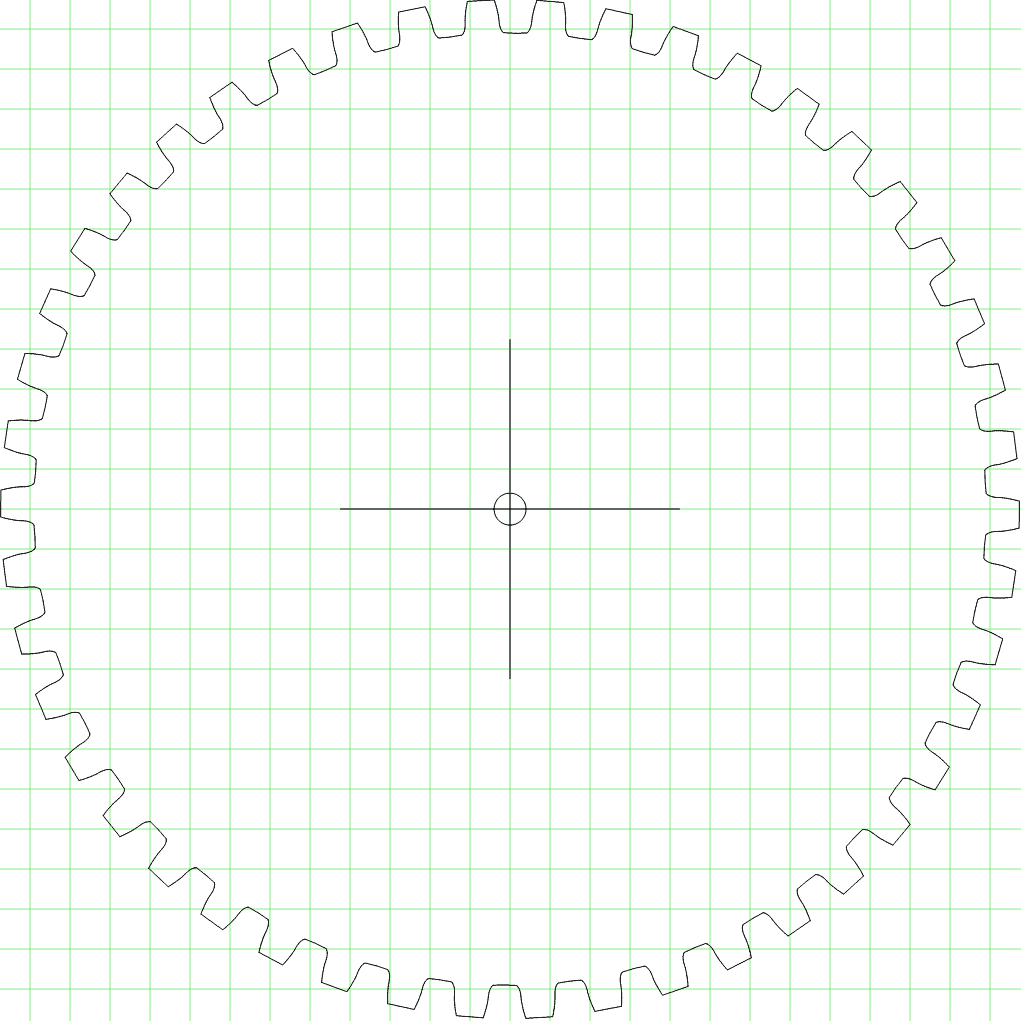
templates/46.png
