JohnFrei/Box-Joint-Jig/templates/46r.png

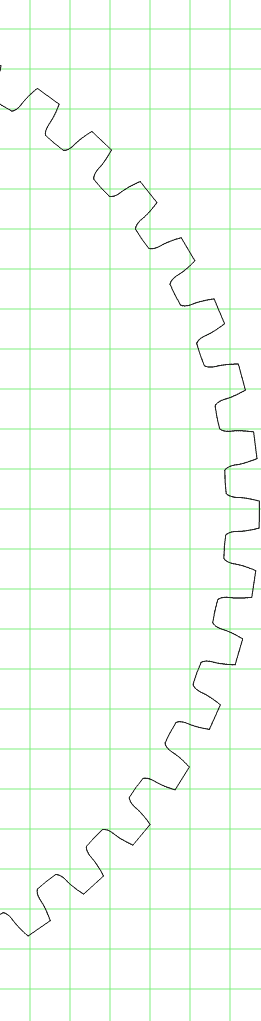
templates/46r.png
