JohnFrei/Box-Joint-Jig/templates/47r.png

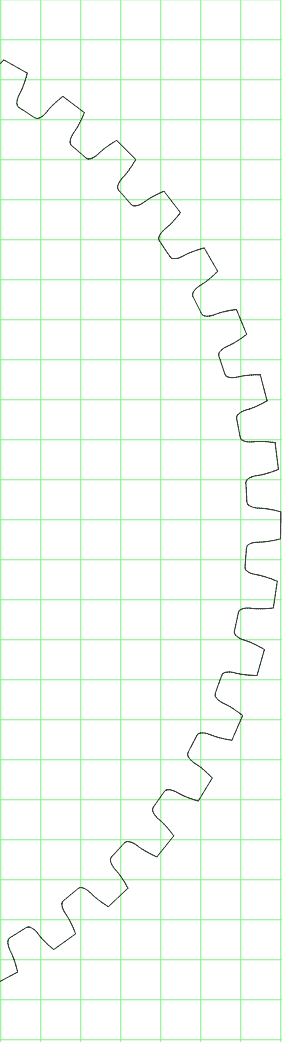
templates/47r.png
