JohnFrei/Box-Joint-Jig/templates/48.png

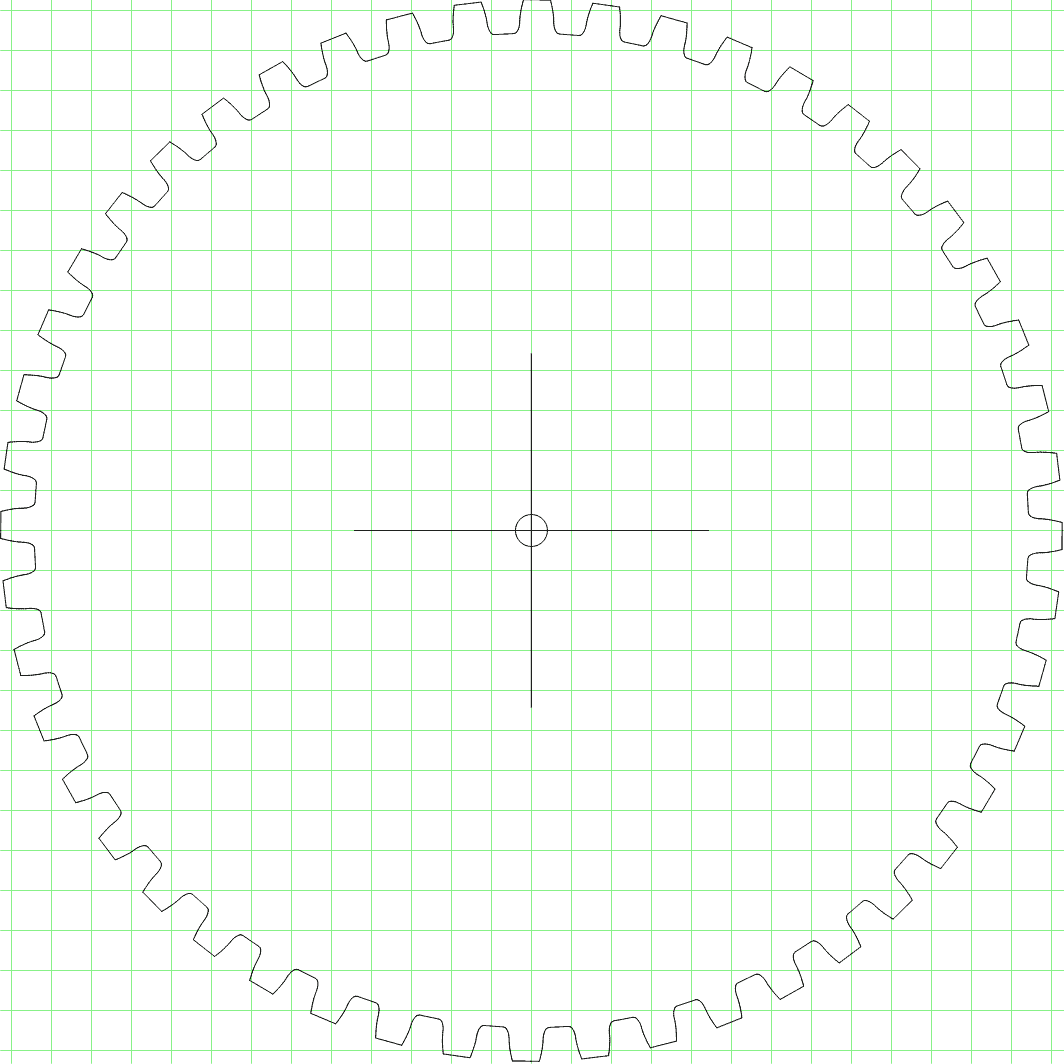
templates/48.png
