JohnFrei/Box-Joint-Jig/templates/48r.png

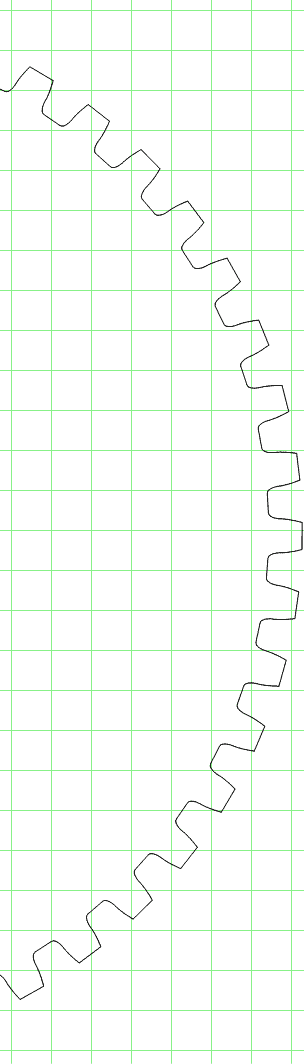
templates/48r.png
