JohnFrei/Box-Joint-Jig/templates/thumbnail/1-1_small.png

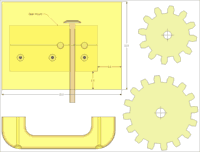
templates/thumbnail/1-1_small.png
