JohnFrei/Box-Joint-Jig/templates/thumbnail/1-1_top_view.png

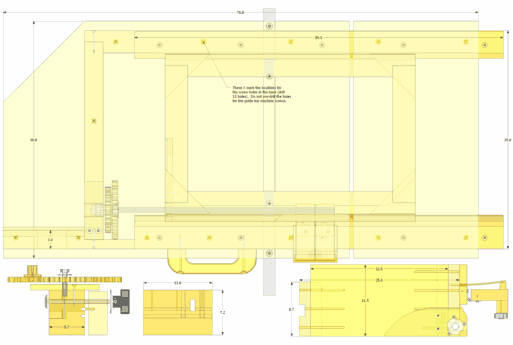
templates/thumbnail/1-1_top_view.png
