JohnFrei/Box-Joint-Jig/(list of files, cad)

Other CAD files:
boxjoint-jig.skp
