JohnFrei/Box-Joint-Jig/plans/box_assembled2.png

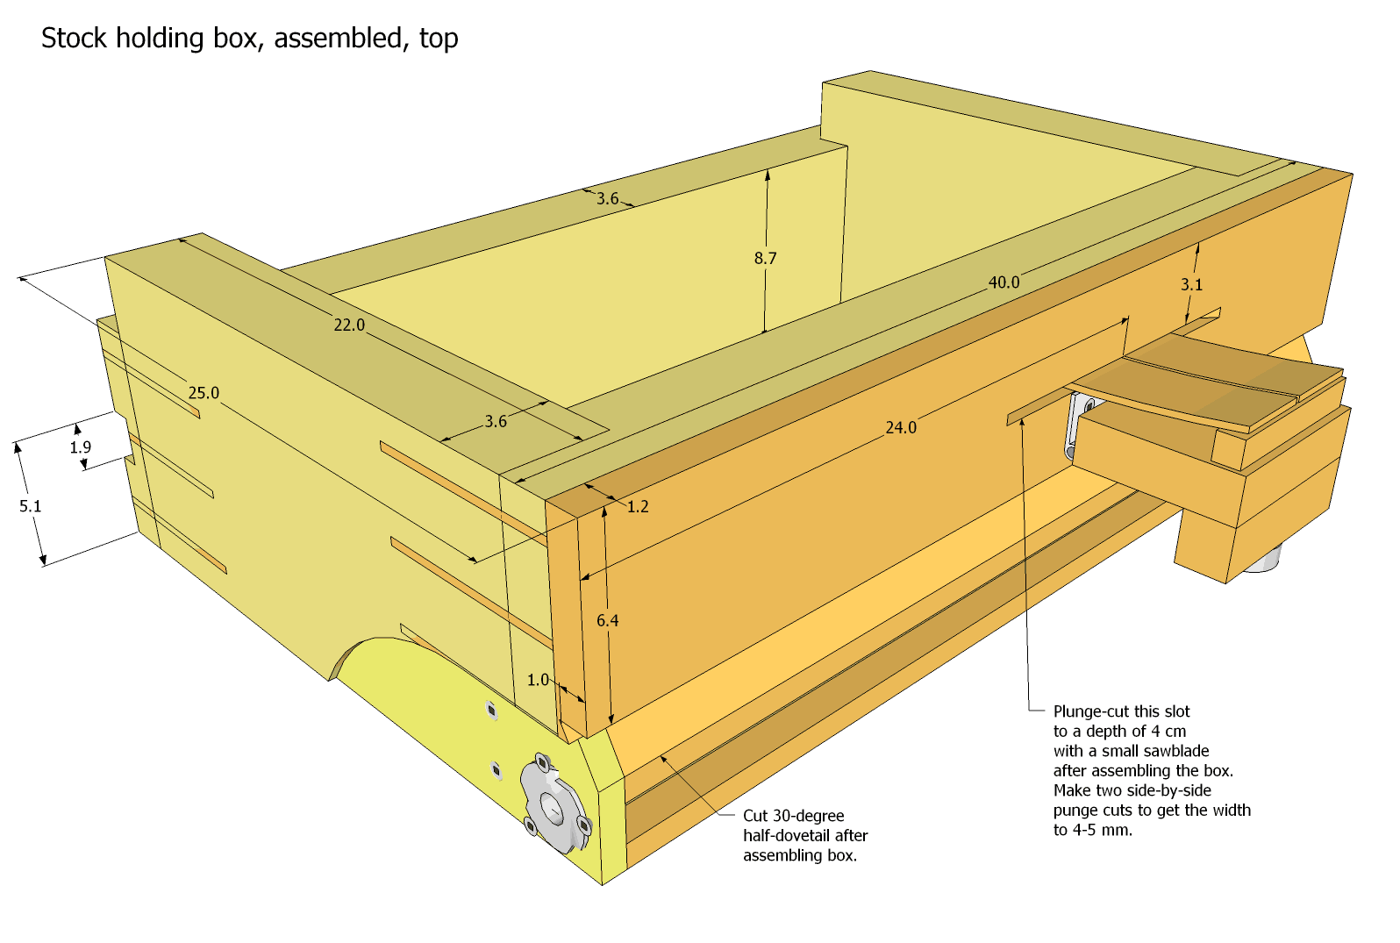
plans/box_assembled2.png
