JohnFrei/Box-Joint-Jig/plans/box_assembled.png

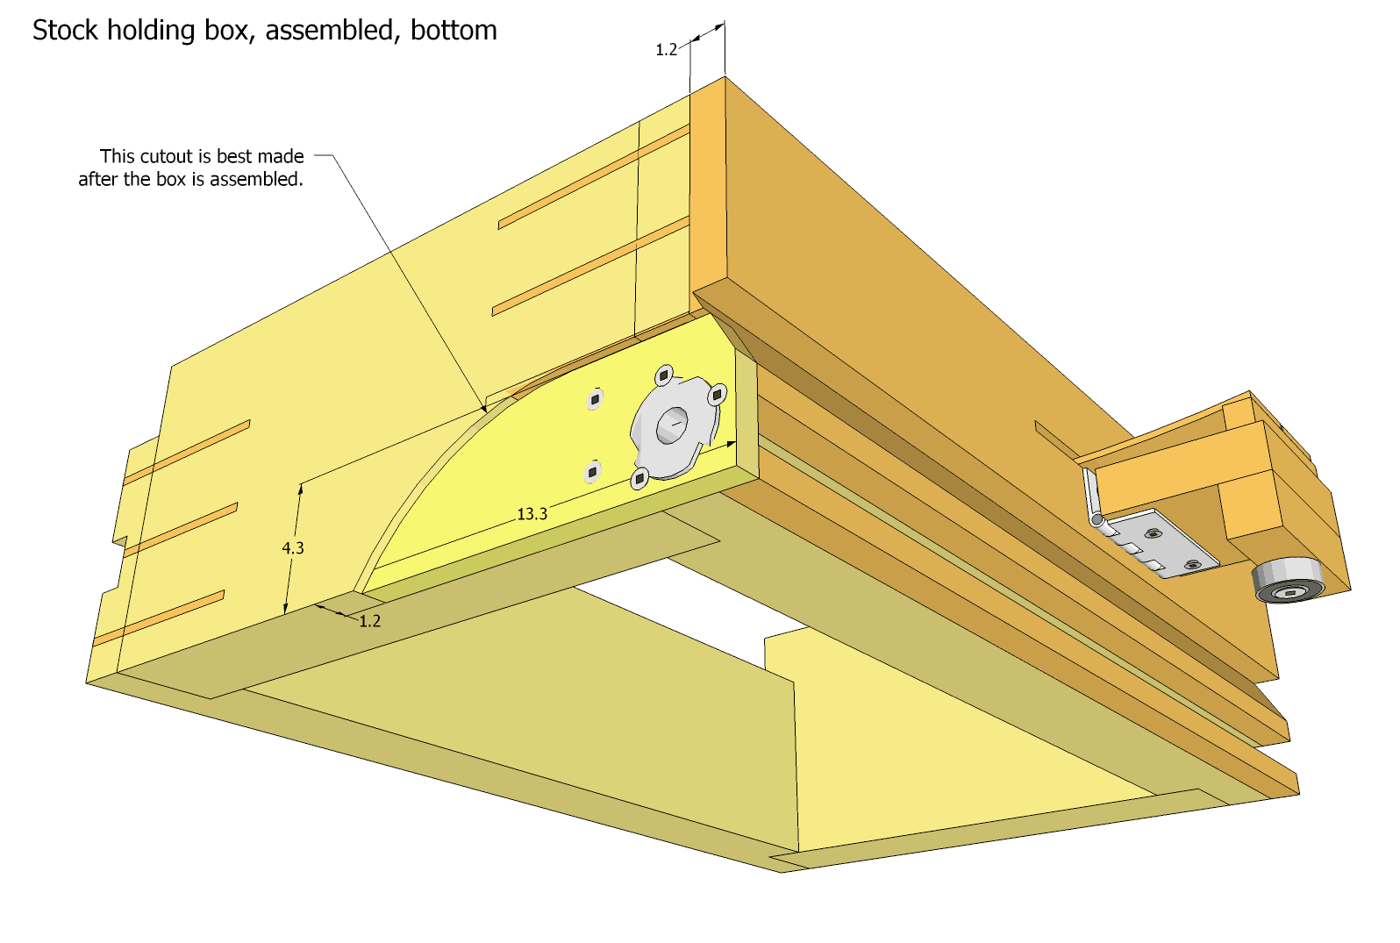
plans/box_assembled.png
