JohnFrei/Box-Joint-Jig/plans/box_assembled_bot.png

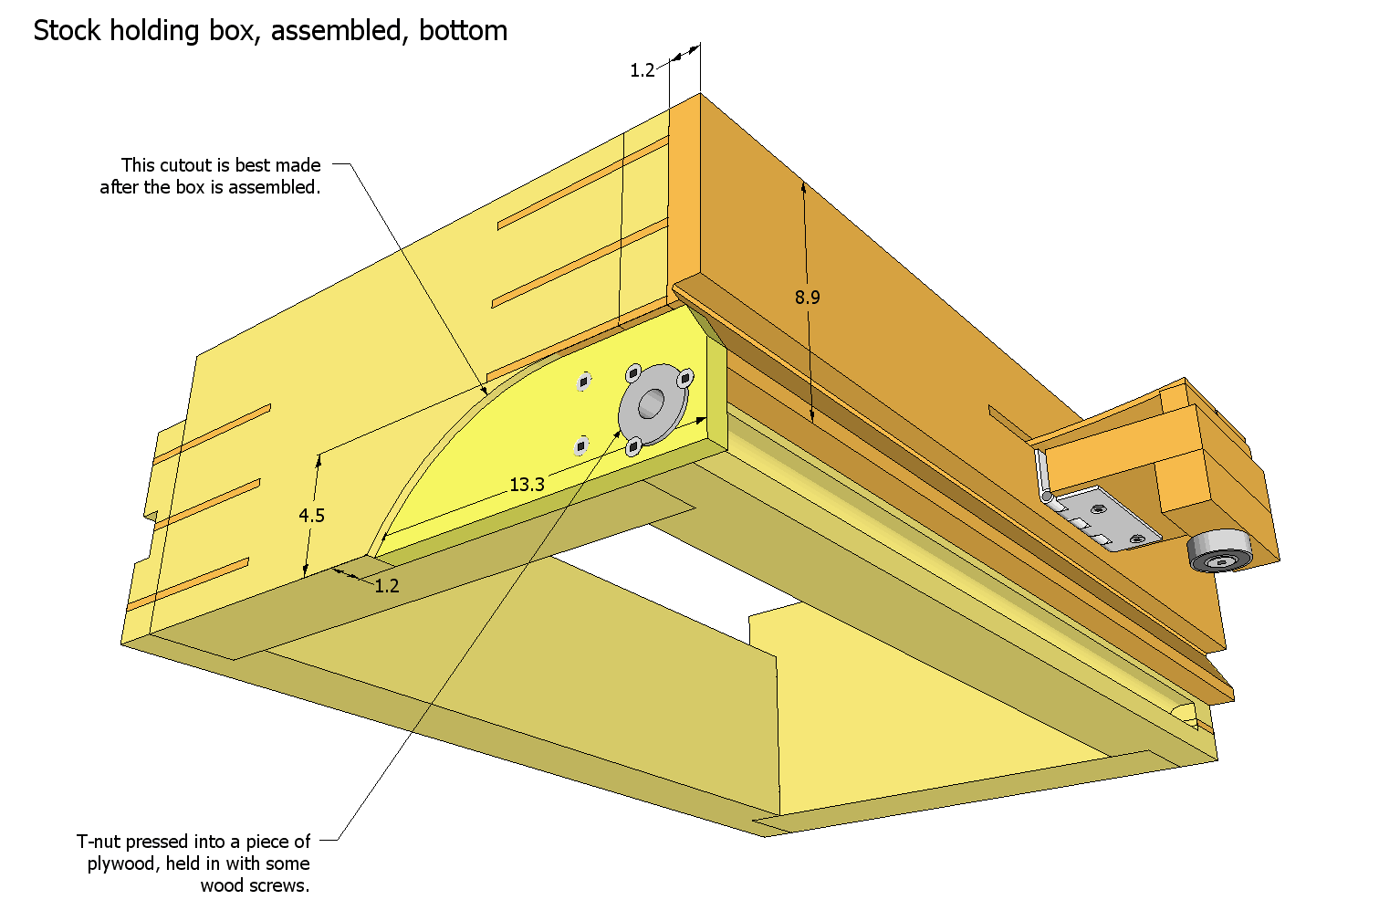
plans/box_assembled_bot.png
