JohnFrei/Box-Joint-Jig/plans/box_assembled_top.png

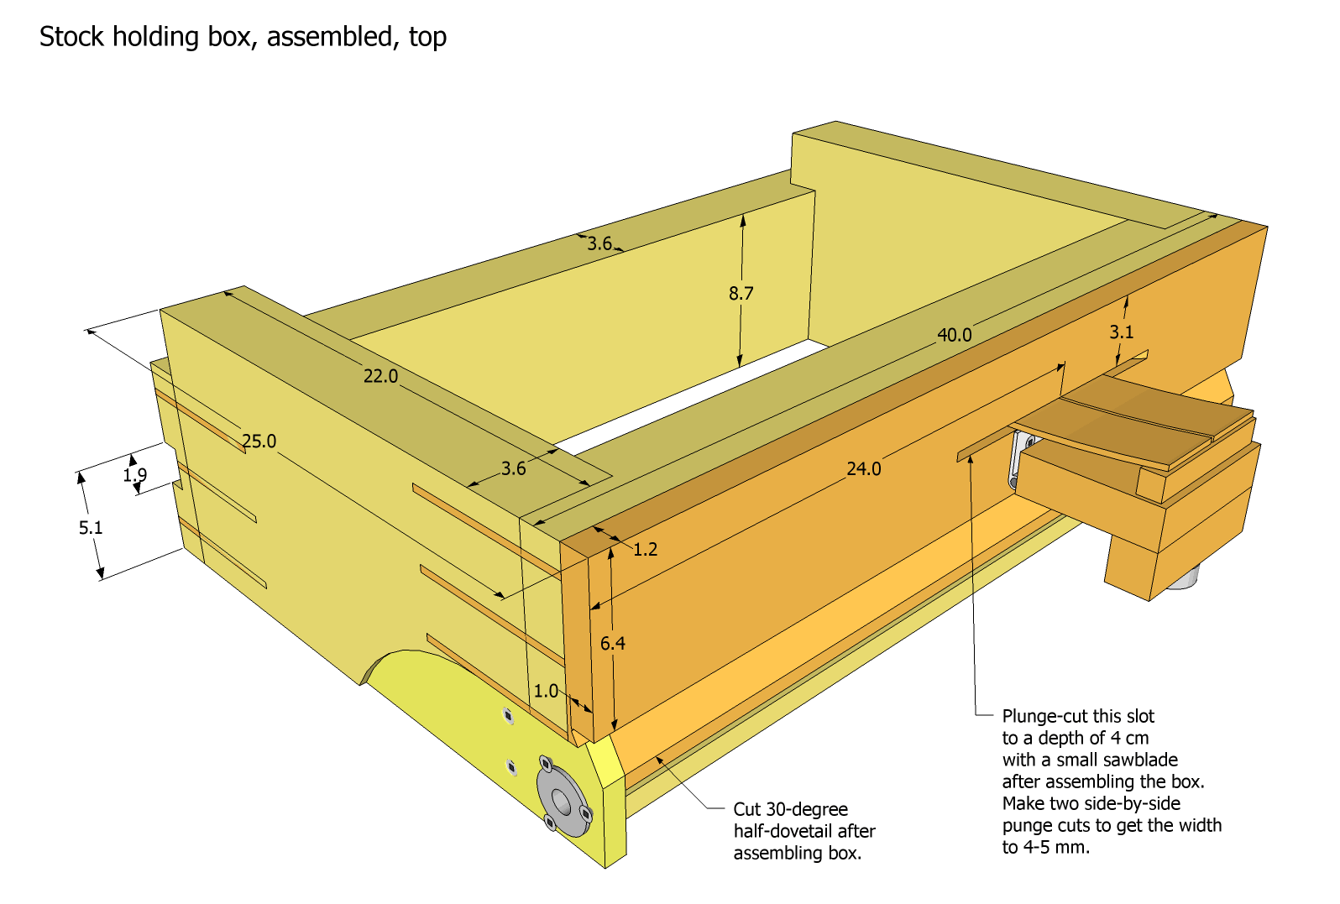
plans/box_assembled_top.png
