JohnFrei/Box-Joint-Jig/plans/guidebar.png

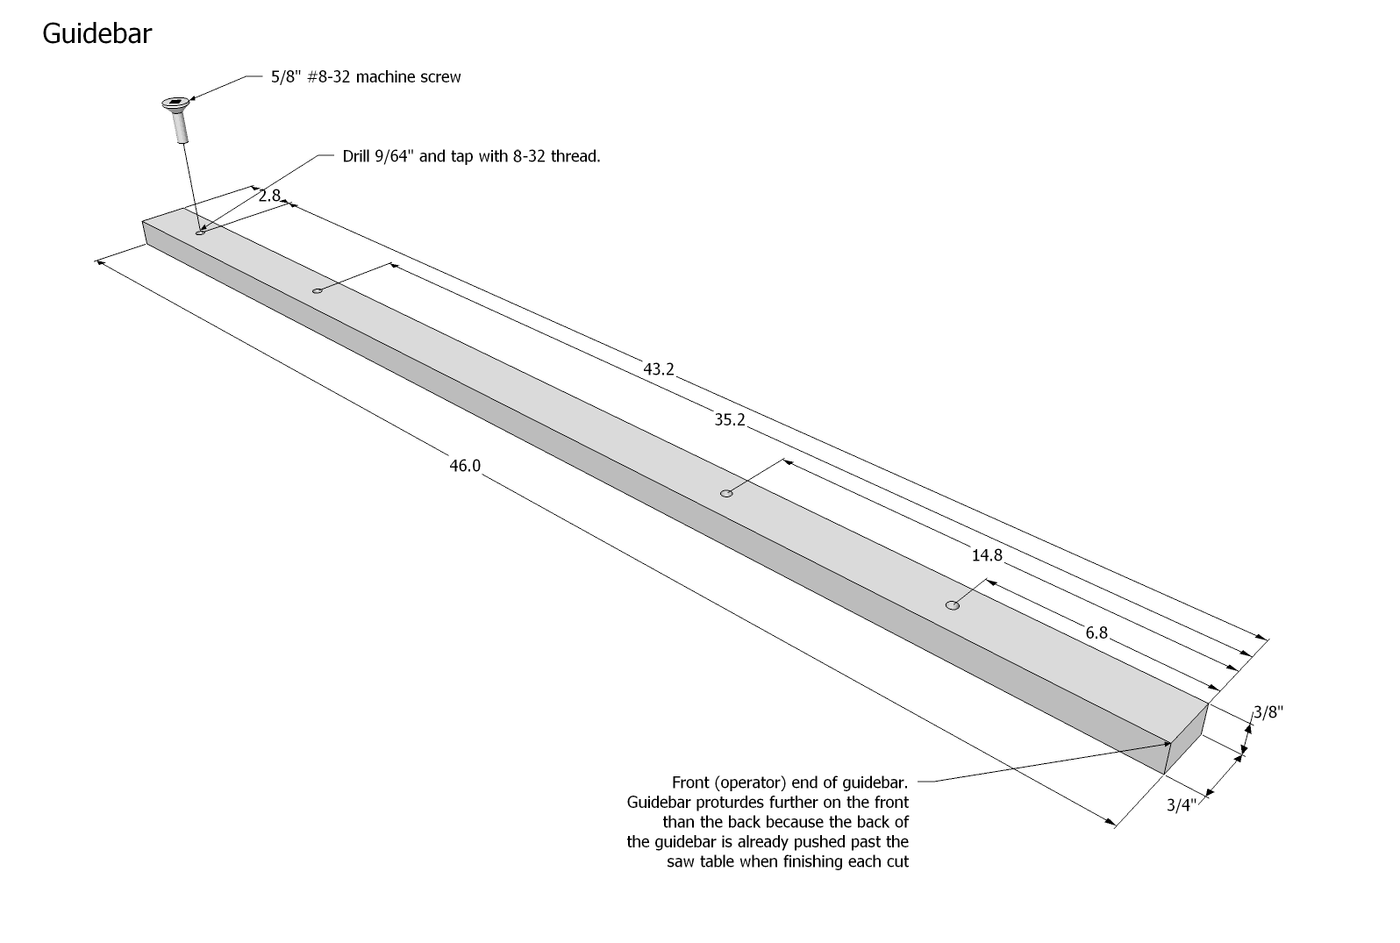
plans/guidebar.png
